guomingloo/planar-acoustic-gripper/experiment_data/BeadSize/WhatsApp Image 2026-06-30 at 16.32.45.jpeg

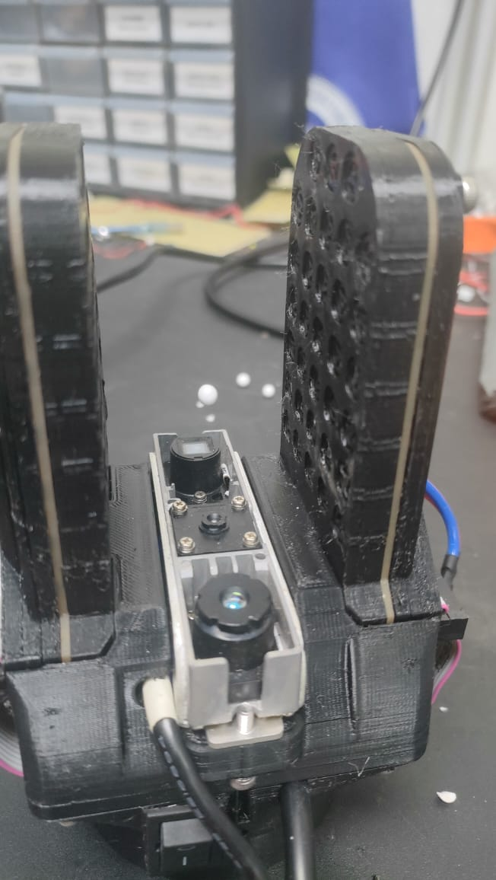
experiment_data/BeadSize/WhatsApp Image 2026-06-30 at 16.32.45.jpeg
