guomingloo/planar-acoustic-gripper/experiment_data/BeadSize/3.8mmEPS.jpeg

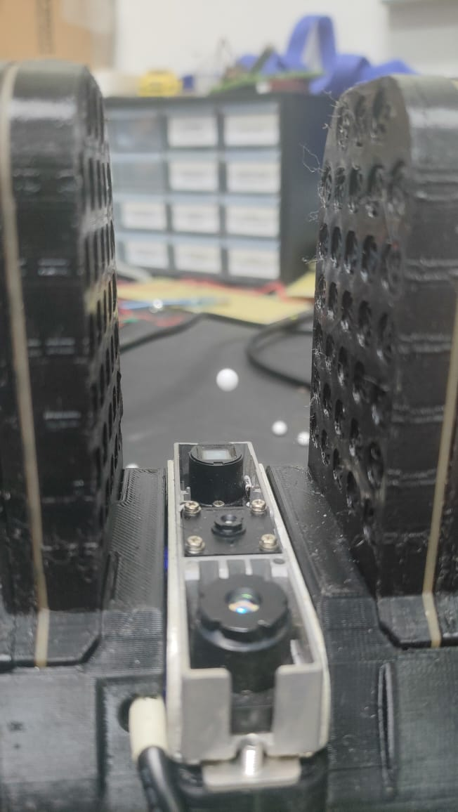
experiment_data/BeadSize/3.8mmEPS.jpeg
