guomingloo/planar-acoustic-gripper/README.md

# planar-acoustic-gripper
Source code ,simulation logs and design files for a 66-channel flat-panel ultrasonic phased array acoustic gripper based on Cyclone IV FPGA integrated with a FLEXIV Rizon 4s 7-DOF robot. EE FYP 2025/2026, Universiti Sains Malaysia (USM).
