guomingloo/planar-acoustic-gripper/Electrical/AcousticGripper/AcousticGripper.step

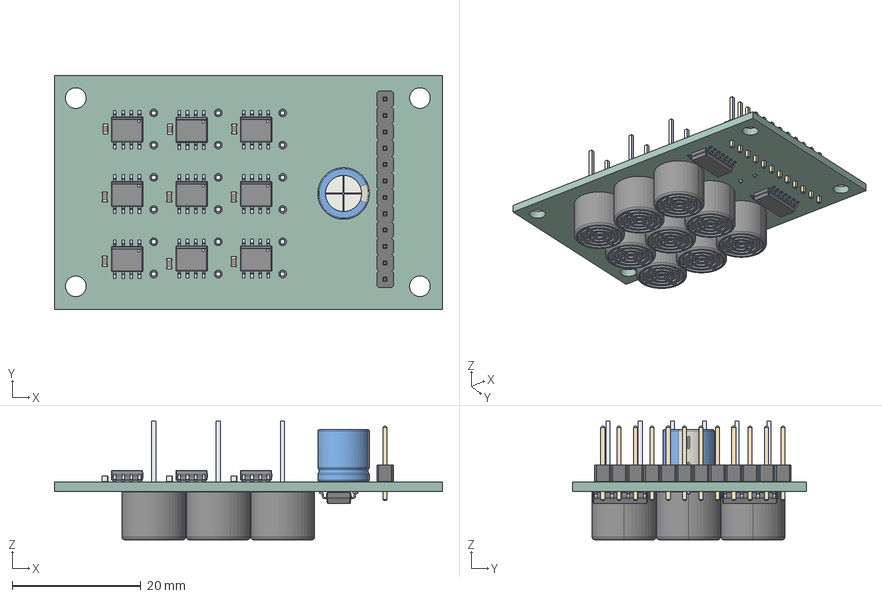
[picture p3: CAD file, 2026-07-02]
Electrical/AcousticGripper/AcousticGripper.step
60.2 x 36.3 x 18.4 mm
DRV8870DDAR x 9
C_0603_1608Metric x 9
CP_Radial_D8.0mm_P3.50mm
PinHeader_1x12_P2.54mm_Vertical
SOIC-14_3.9x8.7mm_P1.27mm x 2
MA40S4R--3DModel-STEP-56544 x 9
AcousticGripper_PCB
