guomingloo/planar-acoustic-gripper/Electrical/BaseStationV1/BaseStationPart2/BaseStationPart2.step

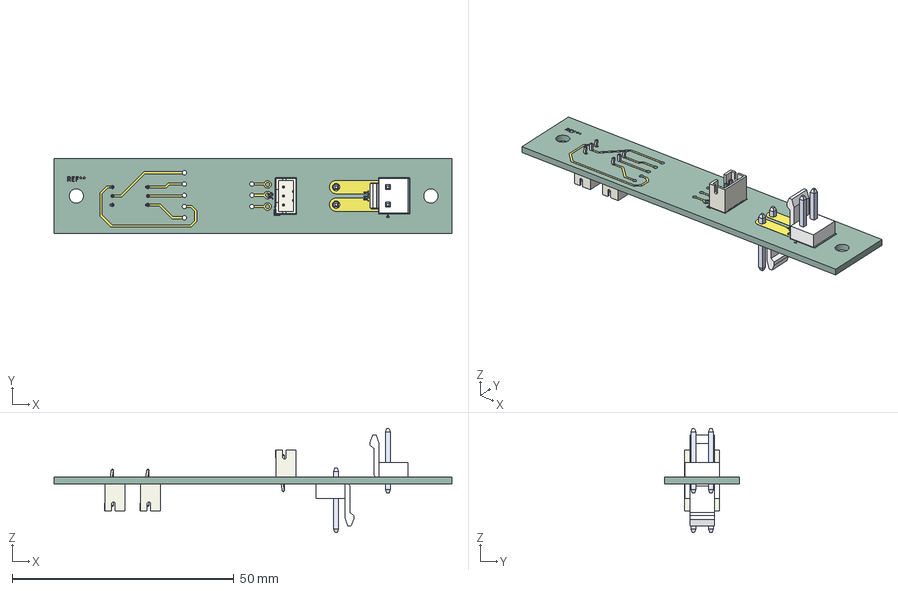
[picture p4: CAD file, 2026-07-02]
Electrical/BaseStationV1/BaseStationPart2/BaseStationPart2.step
89.8 x 17.0 x 23.5 mm
B2P-VH(LF)(SN)_B2P-VH(LF)(SN) x 2
JST_PH_B3B-PH-K_1x03_P2.00mm_Vertical x 3
BaseStationPart2_copper
BaseStationPart2_silkscreen
BaseStationPart2_PCB
