guomingloo/planar-acoustic-gripper/Mechanical/FinalGripperV1.1/MoBo_Case_Middle.SLDPRT

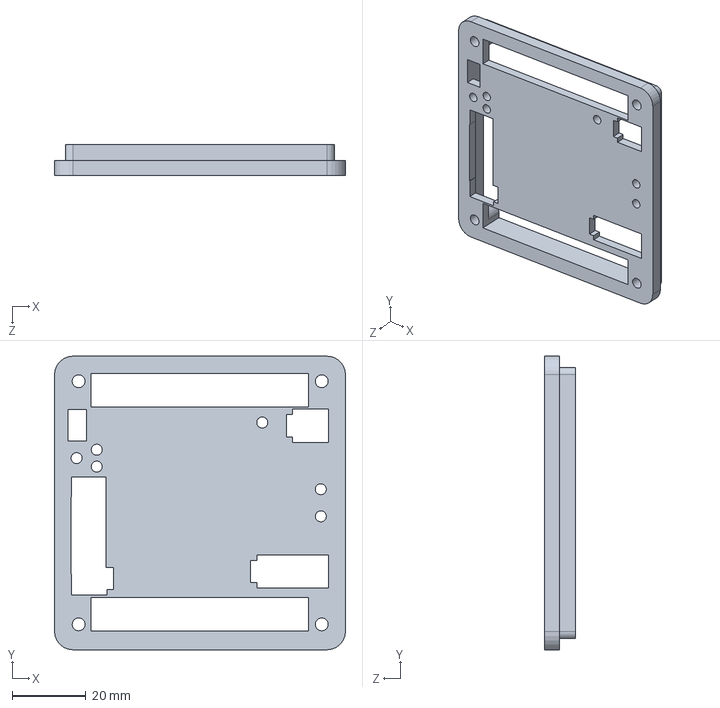
[picture p5: CAD file, 2026-07-02]
Mechanical/FinalGripperV1.1/MoBo_Case_Middle.SLDPRT
79.0 x 79.7 x 8.35 mm
