guomingloo/planar-acoustic-gripper/Mechanical/BaseSationV1/Top_Mid_Frame.SLDPRT

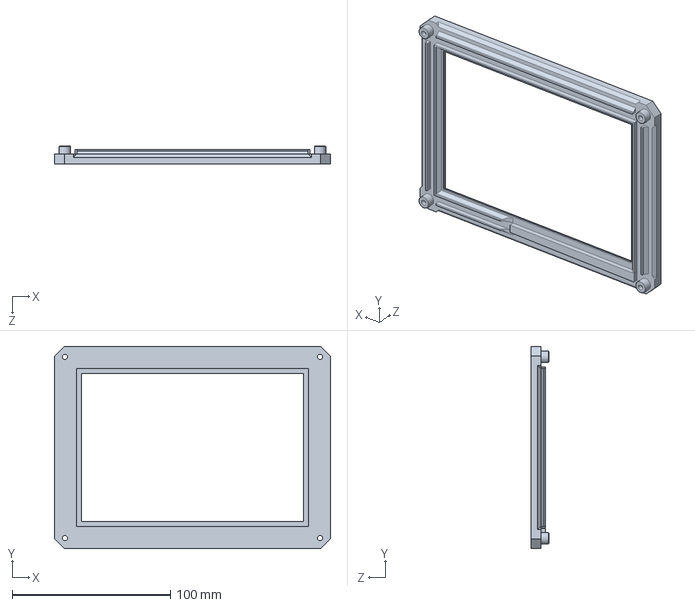
[picture p6: CAD file, 2026-07-02]
Mechanical/BaseSationV1/Top_Mid_Frame.SLDPRT
174.5 x 127.8 x 11.1 mm
