guomingloo/planar-acoustic-gripper/Mechanical/FinalGripperV1.1/Coupler.SLDPRT

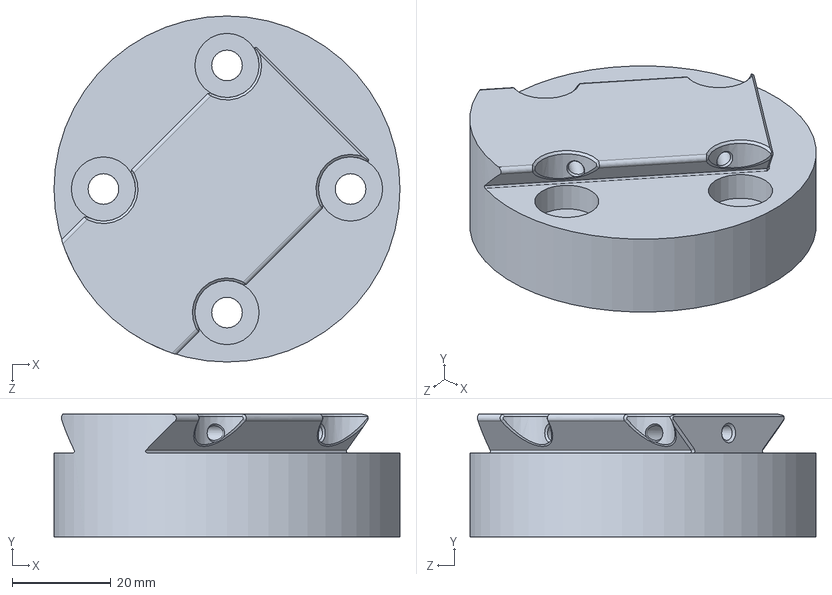
[picture p7: CAD file, 2026-07-02]
Mechanical/FinalGripperV1.1/Coupler.SLDPRT
70.0 x 24.8 x 70.0 mm
