guomingloo/planar-acoustic-gripper/Mechanical/PoC_Gripper/sGripperCase.SLDPRT

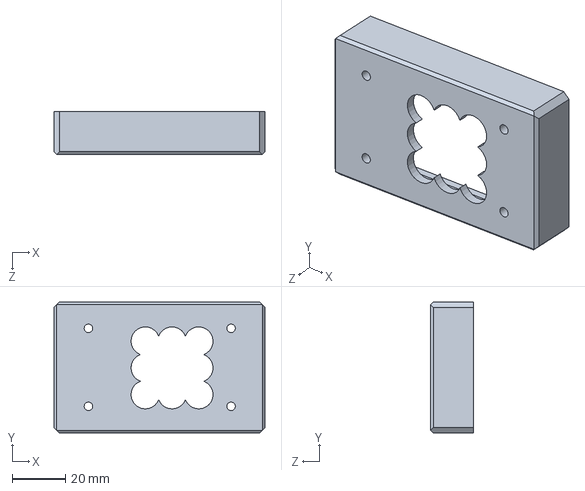
[picture p8: CAD file, 2026-07-02]
Mechanical/PoC_Gripper/sGripperCase.SLDPRT
79.0 x 49.0 x 16.0 mm
