guomingloo/planar-acoustic-gripper/Mechanical/BaseSationV1/Boost_Converter.step

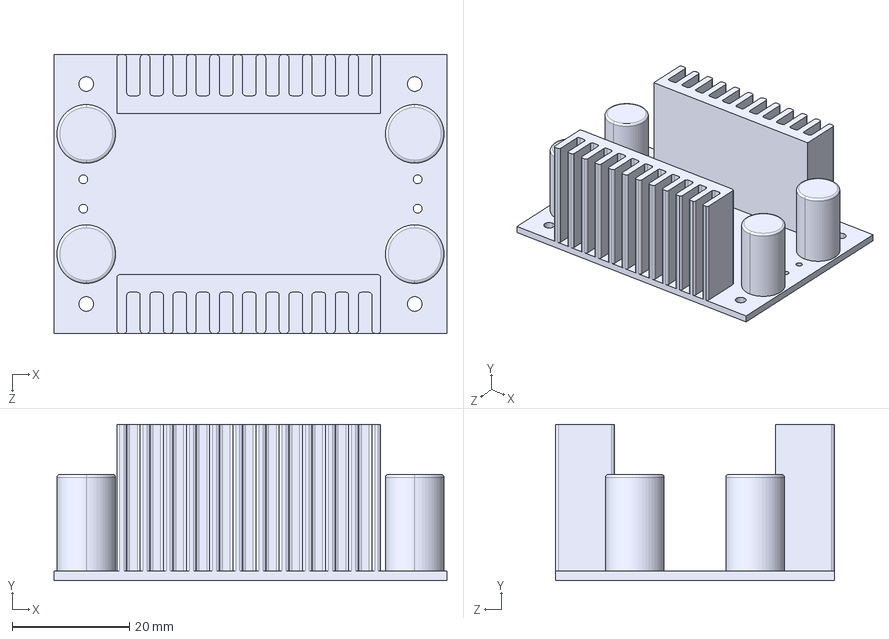
[picture p9: CAD file, 2026-07-02]
Mechanical/BaseSationV1/Boost_Converter.step
67.0 x 26.6 x 47.5 mm
