guomingloo/planar-acoustic-gripper/Mechanical/FinalGripperV1.1/final_Gripper_Case_Middle.SLDPRT

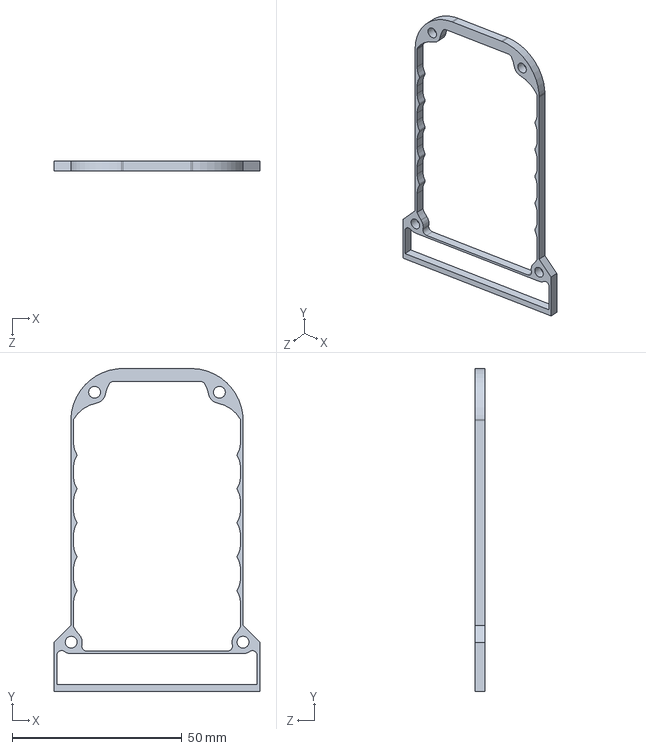
[picture p10: CAD file, 2026-07-02]
Mechanical/FinalGripperV1.1/final_Gripper_Case_Middle.SLDPRT
60.6 x 95.2 x 3.00 mm
