guomingloo/planar-acoustic-gripper/Mechanical/PoC_Gripper/cPlat.SLDPRT

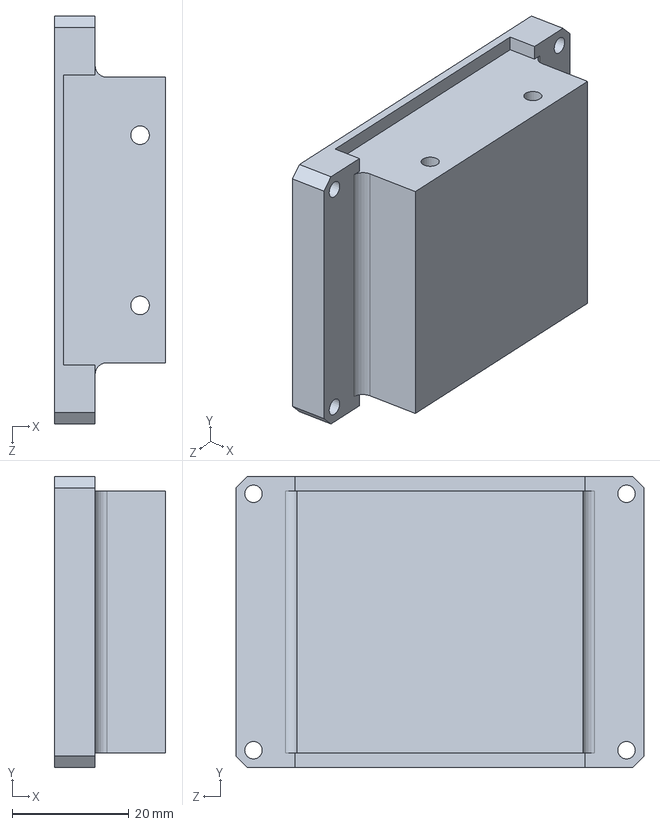
[picture p11: CAD file, 2026-07-02]
Mechanical/PoC_Gripper/cPlat.SLDPRT
19.1 x 50.0 x 70.0 mm
