guomingloo/planar-acoustic-gripper/Mechanical/BaseSationV1/Side_Frame.SLDPRT

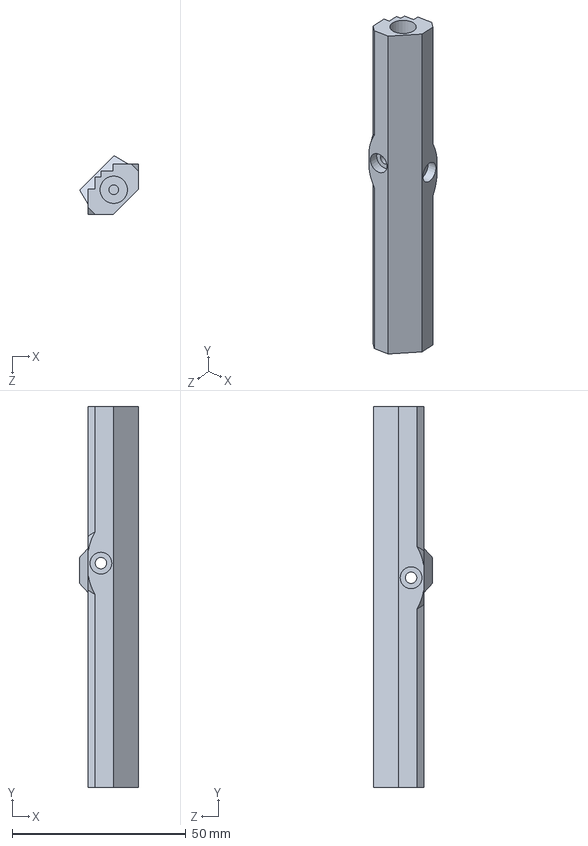
[picture p12: CAD file, 2026-07-02]
Mechanical/BaseSationV1/Side_Frame.SLDPRT
16.9 x 109.7 x 16.9 mm
