guomingloo/planar-acoustic-gripper/Mechanical/FinalGripperV1.1/final_Gripper_Case_Top_Blank.SLDPRT

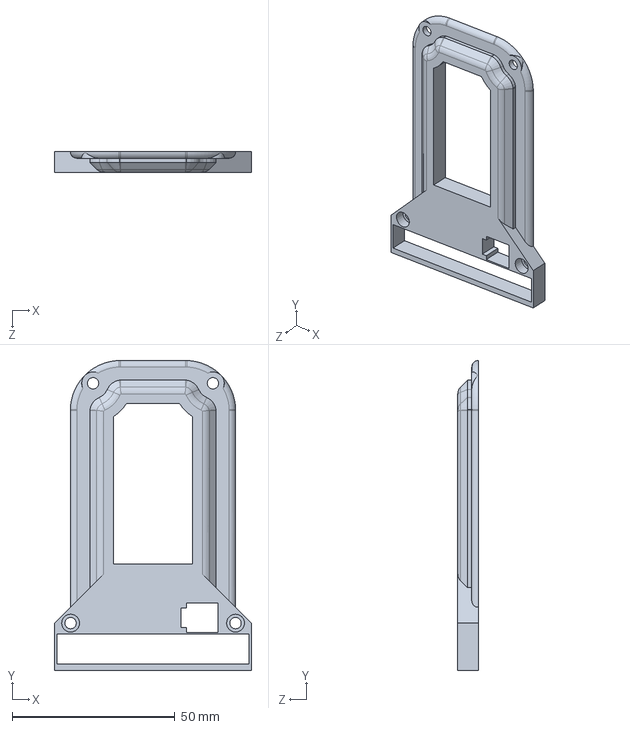
[picture p13: CAD file, 2026-07-02]
Mechanical/FinalGripperV1.1/final_Gripper_Case_Top_Blank.SLDPRT
60.6 x 95.2 x 6.30 mm
