guomingloo/planar-acoustic-gripper/Mechanical/BaseSationV1/Top_Frame.SLDPRT

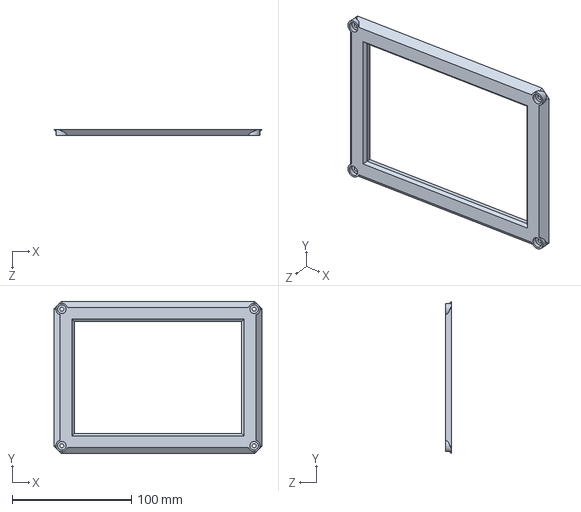
[picture p14: CAD file, 2026-07-02]
Mechanical/BaseSationV1/Top_Frame.SLDPRT
174.5 x 127.8 x 5.00 mm
