guomingloo/planar-acoustic-gripper/Mechanical/FinalGripperV1.1/MoBo_Case.SLDPRT

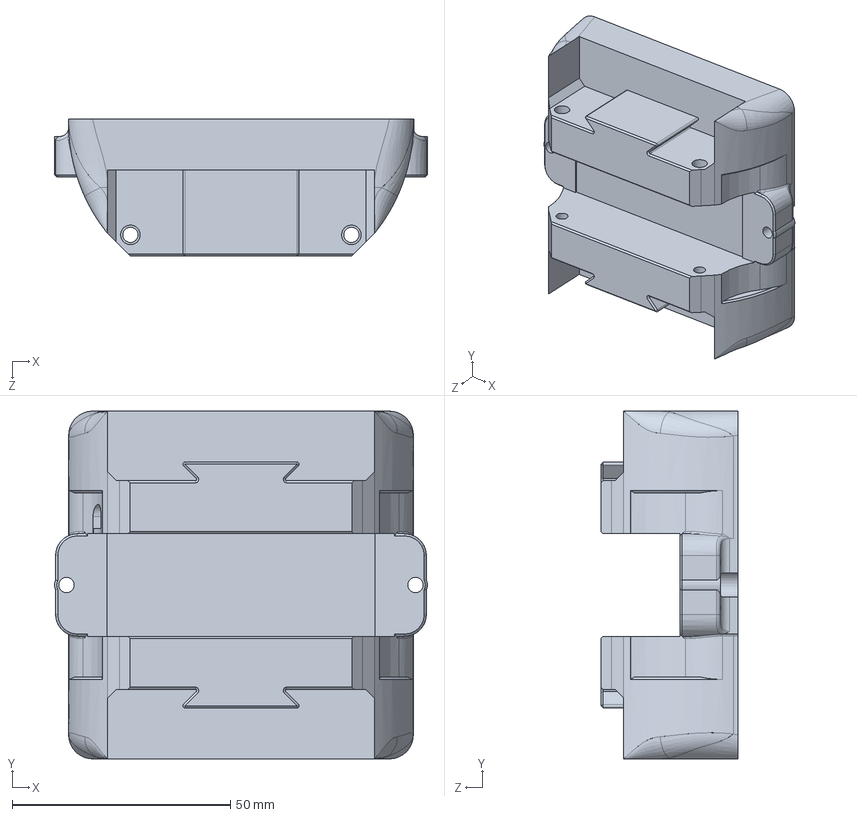
[picture p15: CAD file, 2026-07-02]
Mechanical/FinalGripperV1.1/MoBo_Case.SLDPRT
85.5 x 79.7 x 31.4 mm
