guomingloo/planar-acoustic-gripper/Mechanical/BaseSationV1/middle_frame.SLDPRT

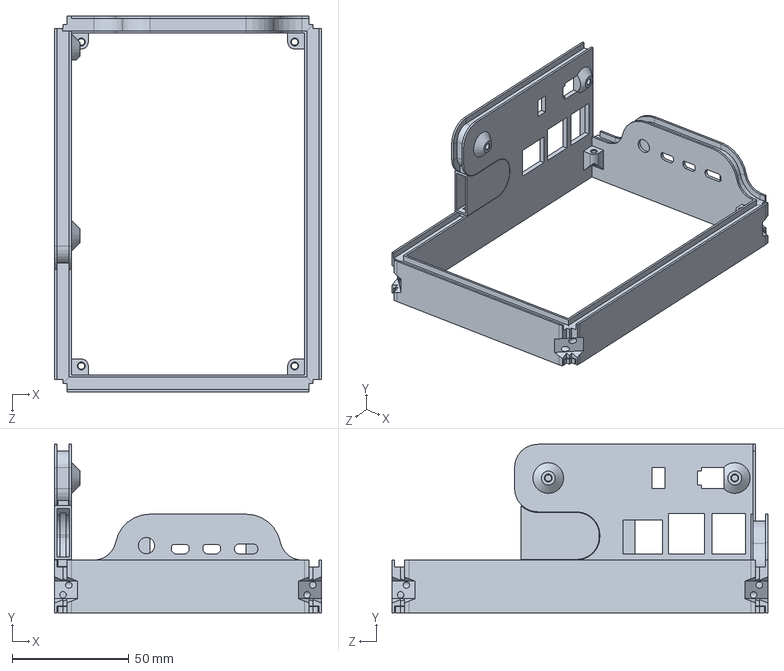
[picture p16: CAD file, 2026-07-02]
Mechanical/BaseSationV1/middle_frame.SLDPRT
114.6 x 72.3 x 161.3 mm
