guomingloo/planar-acoustic-gripper/Mechanical/FinalGripperV1.1/final_Gripper_Case_Bottom.SLDPRT

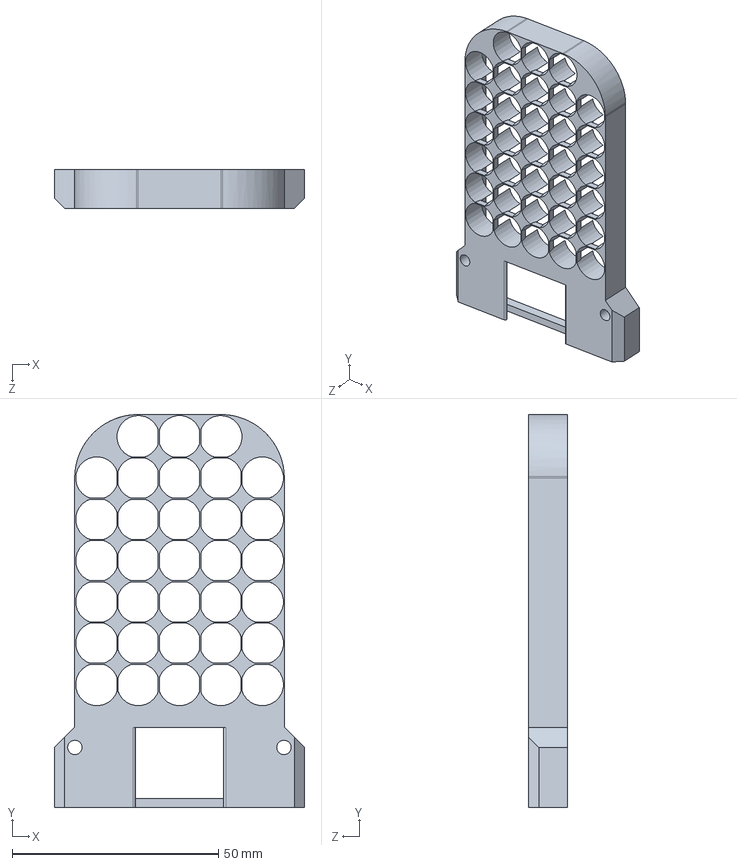
[picture p17: CAD file, 2026-07-02]
Mechanical/FinalGripperV1.1/final_Gripper_Case_Bottom.SLDPRT
60.6 x 95.2 x 9.44 mm
