guomingloo/planar-acoustic-gripper/Mechanical/FinalGripperV1.1/final_Gripper_Case_Top.SLDPRT

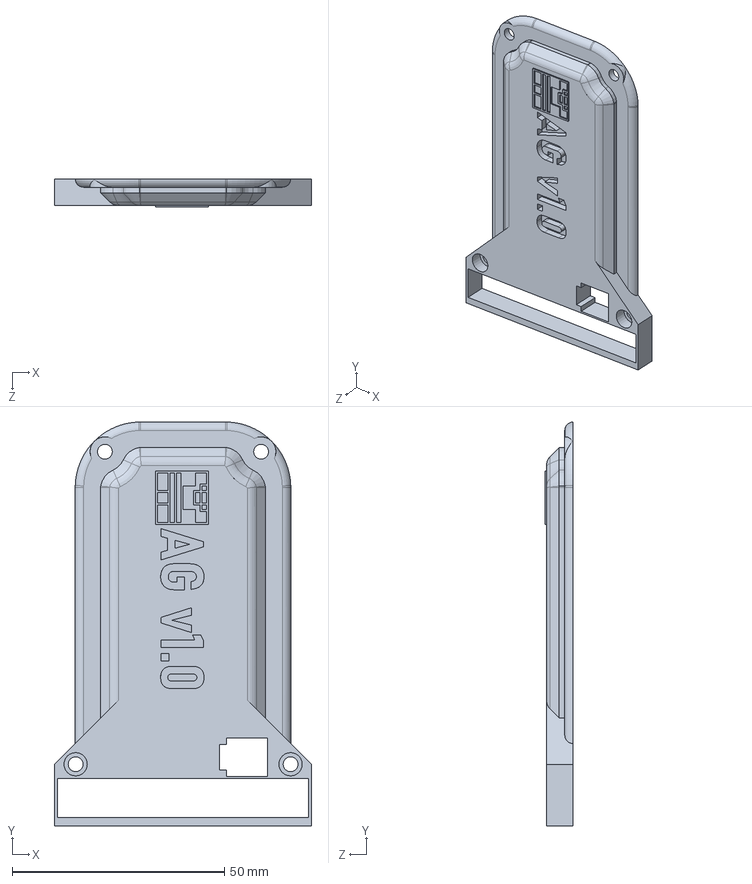
[picture p18: CAD file, 2026-07-02]
Mechanical/FinalGripperV1.1/final_Gripper_Case_Top.SLDPRT
60.6 x 95.2 x 6.70 mm
