guomingloo/planar-acoustic-gripper/Mechanical/FinalGripperV1.1/MoBo_Case_Top.SLDPRT

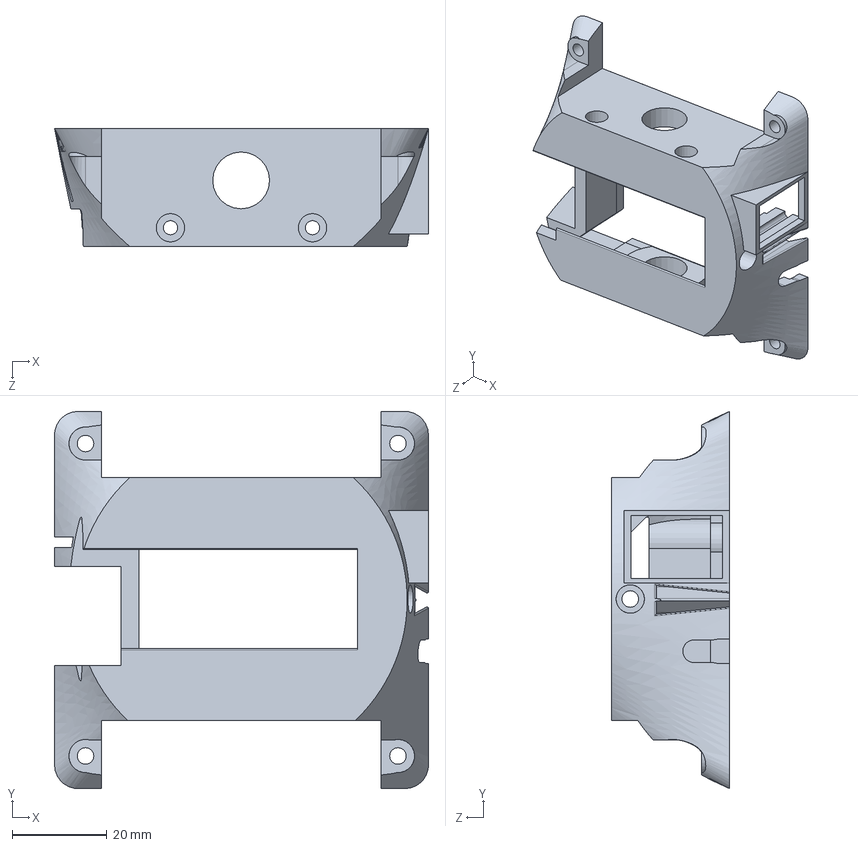
[picture p19: CAD file, 2026-07-02]
Mechanical/FinalGripperV1.1/MoBo_Case_Top.SLDPRT
79.0 x 79.7 x 25.0 mm
