guomingloo/planar-acoustic-gripper/Mechanical/PoC_Gripper/Assem3.SLDASM

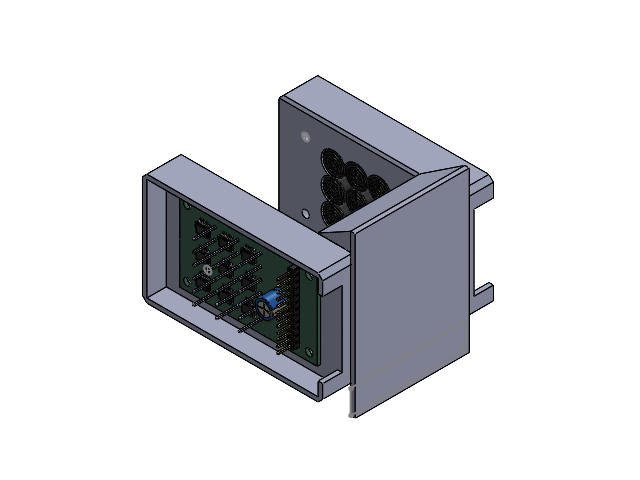
[picture p20: CAD file, 2026-07-02]
Mechanical/PoC_Gripper/Assem3.SLDASM
DRV8870DDAR_1.step x 9
C_0603_1608Metric_1.step x 9
CP_Radial_D8.0mm_P3.50mm_1.step
PinHeader_1x12_P2.54mm_Vertical_1.step
SOIC-14_3.9x8.7mm_P1.27mm_1.step x 2
MA40S4R--3DModel-STEP-56544_1.step x 9
AcousticGripper_PCB_1.step
DRV8870DDAR.step x 9
C_0603_1608Metric.step x 9
CP_Radial_D8.0mm_P3.50mm.step
PinHeader_1x12_P2.54mm_Vertical.step
SOIC-14_3.9x8.7mm_P1.27mm.step x 2
MA40S4R--3DModel-STEP-56544.step x 9
AcousticGripper_PCB.step
sGripperCase x 2
cPlat
