guomingloo/planar-acoustic-gripper/experiment_data/Stability/Stability1.xlsx

t | x | y | 0.0001247677527 | 0.0002685738407
0 | -7.519e-05 | 0.0003387 | 0.0001229200384 | 8.627574153e-05
0.017 | -7.519e-05 | 0.0003387 | 0.00045979 | 0.0003199
0.034 | -7.519e-05 | 0.0003387
0.05 | -7.519e-05 | 0.0003387
0.067 | -7.519e-05 | 0.0003387
0.084 | -7.519e-05 | 0.0003387
0.101 | -7.519e-05 | 0.0003387
0.118 | -7.519e-05 | 0.0003387
0.135 | -7.519e-05 | 0.0003387
0.151 | -7.519e-05 | 0.0003387
0.168 | -7.519e-05 | 0.0003387
0.185 | -1.522e-05 | 0.0002587
0.202 | 6.475e-05 | 0.0002587
0.219 | 0.0001047 | 0.0002187
0.236 | 0.0001047 | 0.0002187
0.252 | 0.0001047 | 0.0002187
0.269 | 0.0001047 | 0.0002187
0.286 | 0.0001047 | 0.0002187
0.303 | 0.0001047 | 0.0002187
0.32 | 0.0001047 | 0.0002187
0.337 | 0.0001047 | 0.0002187
0.353 | 0.0001047 | 0.0002187
0.37 | 0.0001047 | 0.0002187
0.387 | 0.0001047 | 0.0002187
0.404 | 0.0001047 | 0.0002187
0.421 | 0.0001047 | 0.0002187
0.438 | 0.0001047 | 0.0002187
0.454 | 0.0001047 | 0.0002187
0.471 | 0.0001047 | 0.0002187
0.488 | 0.0001047 | 0.0002187
0.505 | 0.0001047 | 0.0002187
0.522 | 0.0001047 | 0.0002187
0.539 | 0.0001047 | 0.0002187
0.555 | 0.0001047 | 0.0002187
0.572 | 0.0001047 | 0.0002187
0.589 | 0.0001047 | 0.0002187
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
