guomingloo/planar-acoustic-gripper/experiment_data/x_movement_data/X_Movement.xlsx

t | x | y | X-axis(mm) | Z-axis(mm)
0 | 1.67e-05 | 1.518e-06 | 0.0167 | 0.001518 | 3.522 | -4.001
0.306 | -0.0001786 | 4.925e-05 | -0.1786 | 0.04925
0.612 | -0.0003495 | 7.04e-05 | -0.3495 | 0.0704
0.917 | -0.0003252 | 3.995e-05 | -0.3252 | 0.03995
1.223 | -0.0003544 | -3.478e-05 | -0.3544 | -0.03478
1.529 | -0.0003634 | -3.874e-05 | -0.3634 | -0.03874
1.835 | -0.0005385 | 5.433e-05 | -0.5385 | 0.05433
2.141 | -0.0006227 | -7.347e-06 | -0.6227 | -0.007347
2.446 | -0.0006244 | 4.433e-05 | -0.6244 | 0.04433
2.752 | -0.0007057 | 8.334e-05 | -0.7057 | 0.08334
3.058 | -0.0006263 | 5.906e-05 | -0.6263 | 0.05906
3.364 | -0.0008628 | 9.923e-05 | -0.8628 | 0.09923
3.67 | -0.0009029 | 0.0001246 | -0.9029 | 0.1246
3.976 | -0.0007547 | -6.003e-07 | -0.7547 | -0.0006003
4.281 | -0.0008637 | -1.738e-05 | -0.8637 | -0.01738
4.587 | -0.0009286 | -2.497e-05 | -0.9286 | -0.02497
4.893 | -0.001252 | 5.197e-05 | -1.252 | 0.05197
5.199 | -0.001261 | 5.545e-05 | -1.261 | 0.05545
5.505 | -0.0012 | -3.404e-05 | -1.2 | -0.03404
5.81 | -0.001129 | -7.849e-06 | -1.129 | -0.007849
6.116 | -0.001236 | 1.847e-05 | -1.236 | 0.01847
6.422 | -0.001451 | 9.281e-05 | -1.451 | 0.09281
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
