guomingloo/planar-acoustic-gripper/experiment_data/y_movement_data/Y_Movement.xlsx

t | Y-axis | Z-axis | Y-axis(mm) | Z-axis(mm)
0 | 6.495e-06 | -6.554e-06 | 0.006495 | -0.006554
0.017 | 1.588e-05 | -1.124e-05 | 0.01588 | -0.01124
0.034 | 4.861e-05 | -6.978e-06 | 0.04861 | -0.006978
0.051 | 4.364e-05 | 3.283e-05 | 0.04364 | 0.03283
0.067 | 4.364e-05 | 3.283e-05 | 0.04364 | 0.03283
0.084 | 4.364e-05 | 3.283e-05 | 0.04364 | 0.03283
0.101 | 4.364e-05 | 3.283e-05 | 0.04364 | 0.03283
0.118 | 4.364e-05 | 3.283e-05 | 0.04364 | 0.03283
0.135 | 4.364e-05 | 3.283e-05 | 0.04364 | 0.03283
0.152 | 4.364e-05 | 3.283e-05 | 0.04364 | 0.03283
0.169 | 3.368e-05 | 3.283e-05 | 0.03368 | 0.03283
0.185 | 2.373e-05 | 3.283e-05 | 0.02373 | 0.03283
0.202 | 5.359e-05 | 3.283e-05 | 0.05359 | 0.03283
0.219 | 8.344e-05 | 3.283e-05 | 0.08344 | 0.03283
0.236 | 0.0001083 | 4.278e-05 | 0.1083 | 0.04278
0.253 | 0.0001083 | 4.278e-05 | 0.1083 | 0.04278
0.27 | 0.0001133 | 6.269e-05 | 0.1133 | 0.06269
0.286 | 0.0001133 | 9.752e-05 | 0.1133 | 0.09752
0.303 | 0.0001133 | 8.757e-05 | 0.1133 | 0.08757
0.32 | 0.0001133 | 8.757e-05 | 0.1133 | 0.08757
0.337 | 0.0001183 | 8.259e-05 | 0.1183 | 0.08259
0.354 | 0.0001183 | 8.259e-05 | 0.1183 | 0.08259
0.371 | 0.0001183 | 8.259e-05 | 0.1183 | 0.08259
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
