guomingloo/planar-acoustic-gripper/experiment_data/BeadSize/2.3mmEPS.jpeg

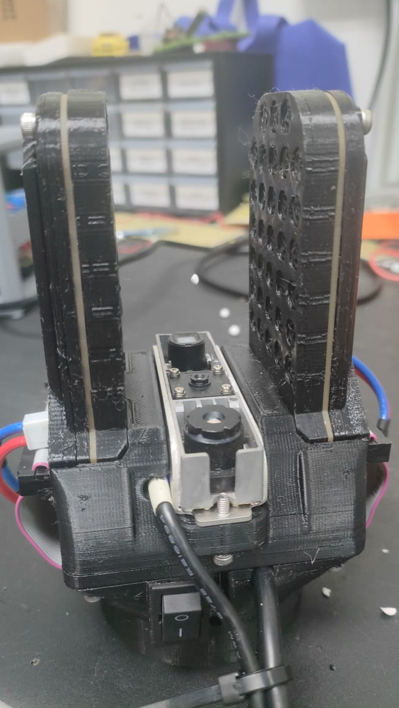
experiment_data/BeadSize/2.3mmEPS.jpeg
