guomingloo/planar-acoustic-gripper/experiment_data/BeadSize/2.5mmEPS.jpeg

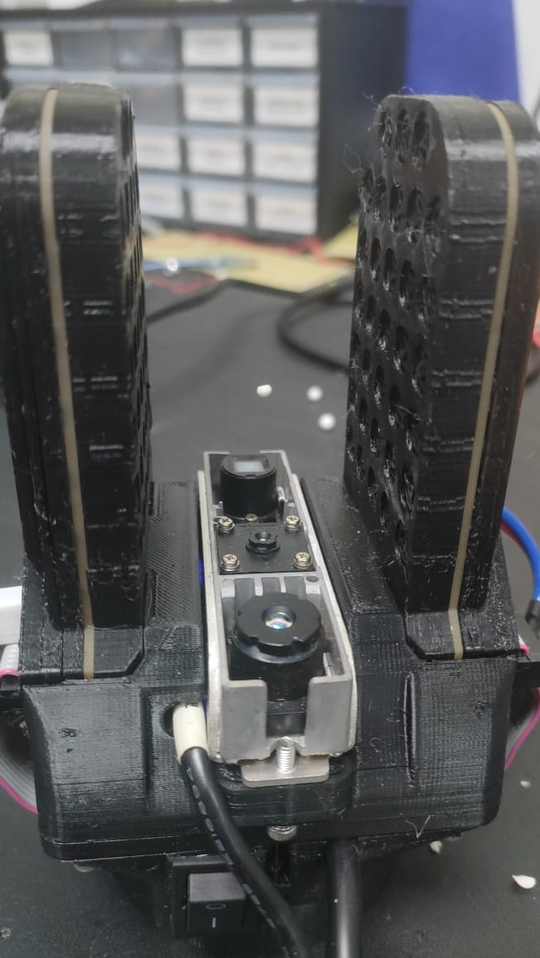
experiment_data/BeadSize/2.5mmEPS.jpeg
