guomingloo/planar-acoustic-gripper/experiment_data/BeadSize/2.8mmEPS.jpeg

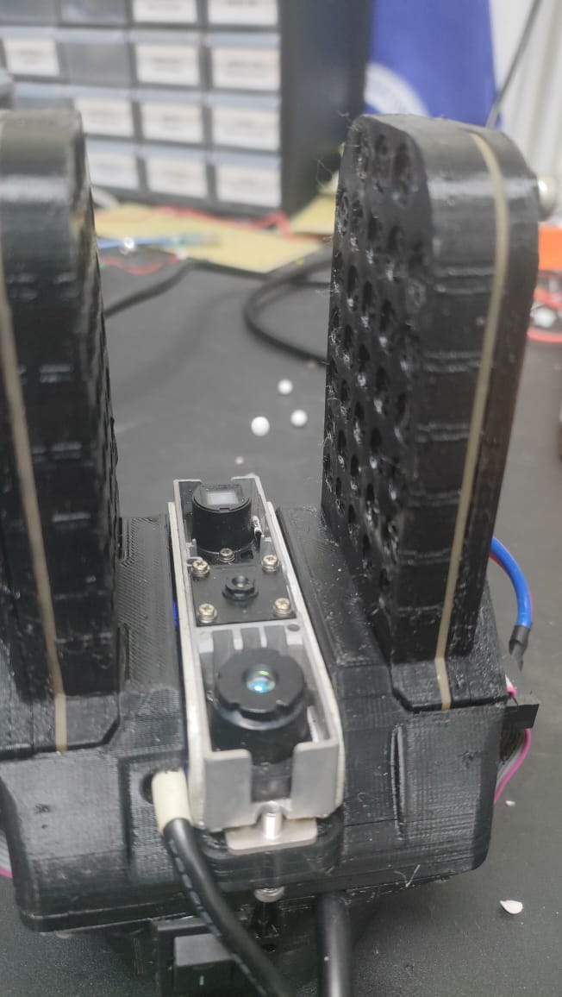
experiment_data/BeadSize/2.8mmEPS.jpeg
