guomingloo/planar-acoustic-gripper/experiment_data/BeadSize/3.4mmEPS.jpeg

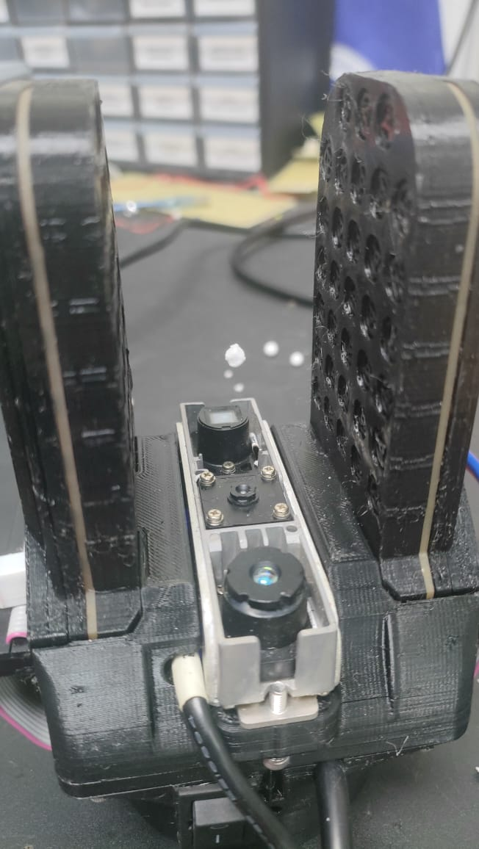
experiment_data/BeadSize/3.4mmEPS.jpeg
