guomingloo/planar-acoustic-gripper/experiment_data/BeadSize/3mmEPS.jpeg

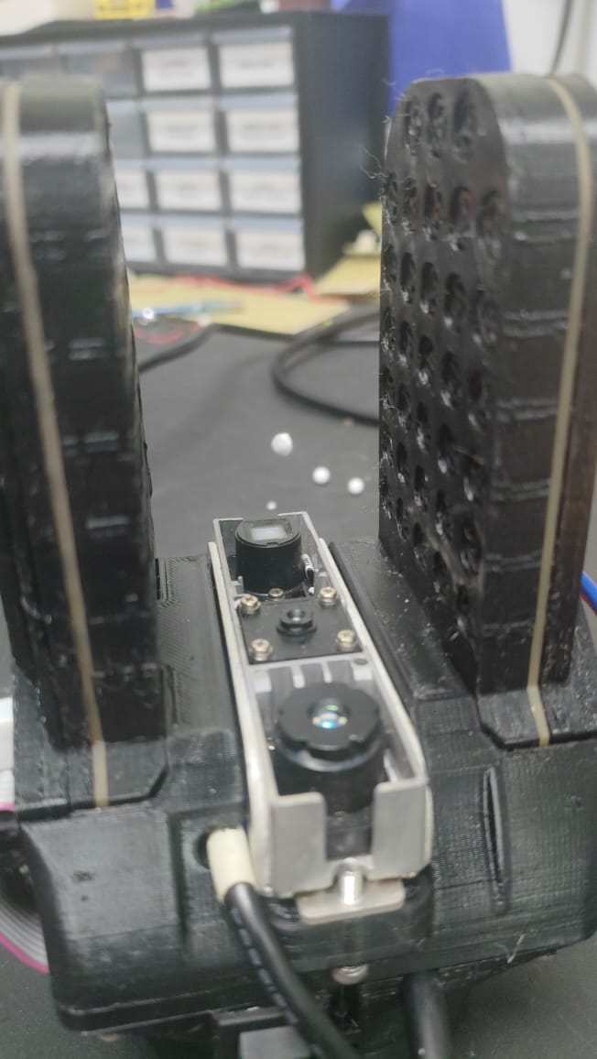
experiment_data/BeadSize/3mmEPS.jpeg
