guomingloo/planar-acoustic-gripper/experiment_data/BeadSize/WhatsApp Image 2026-06-30 at 16.32.46(1).jpeg

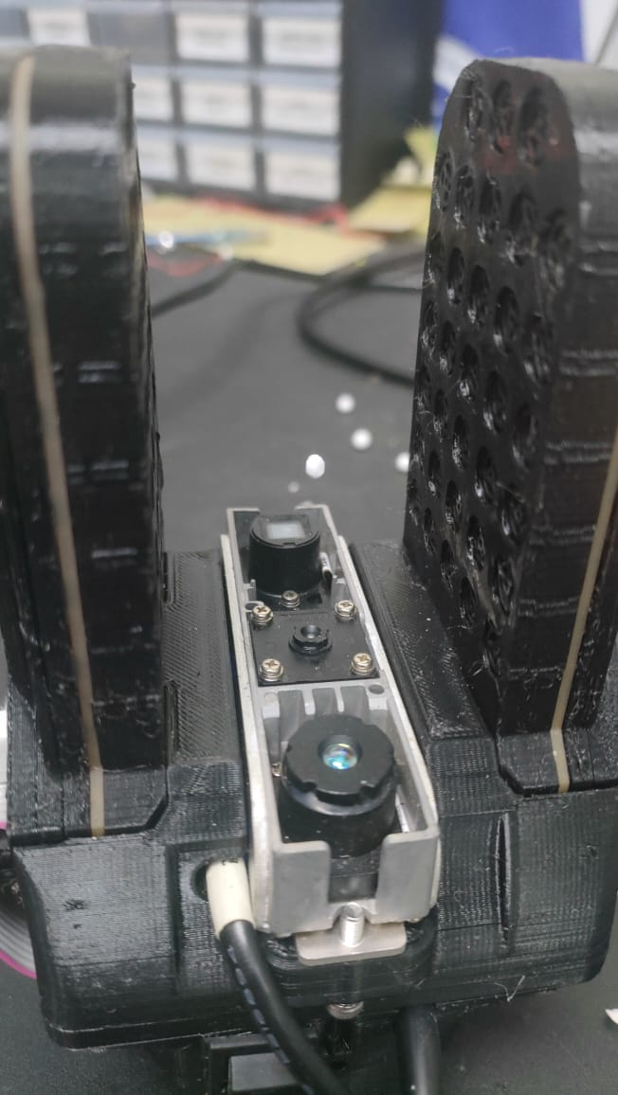
experiment_data/BeadSize/WhatsApp Image 2026-06-30 at 16.32.46(1).jpeg
