guomingloo/planar-acoustic-gripper/experiment_data/Repeatability/aligned_cycles.png

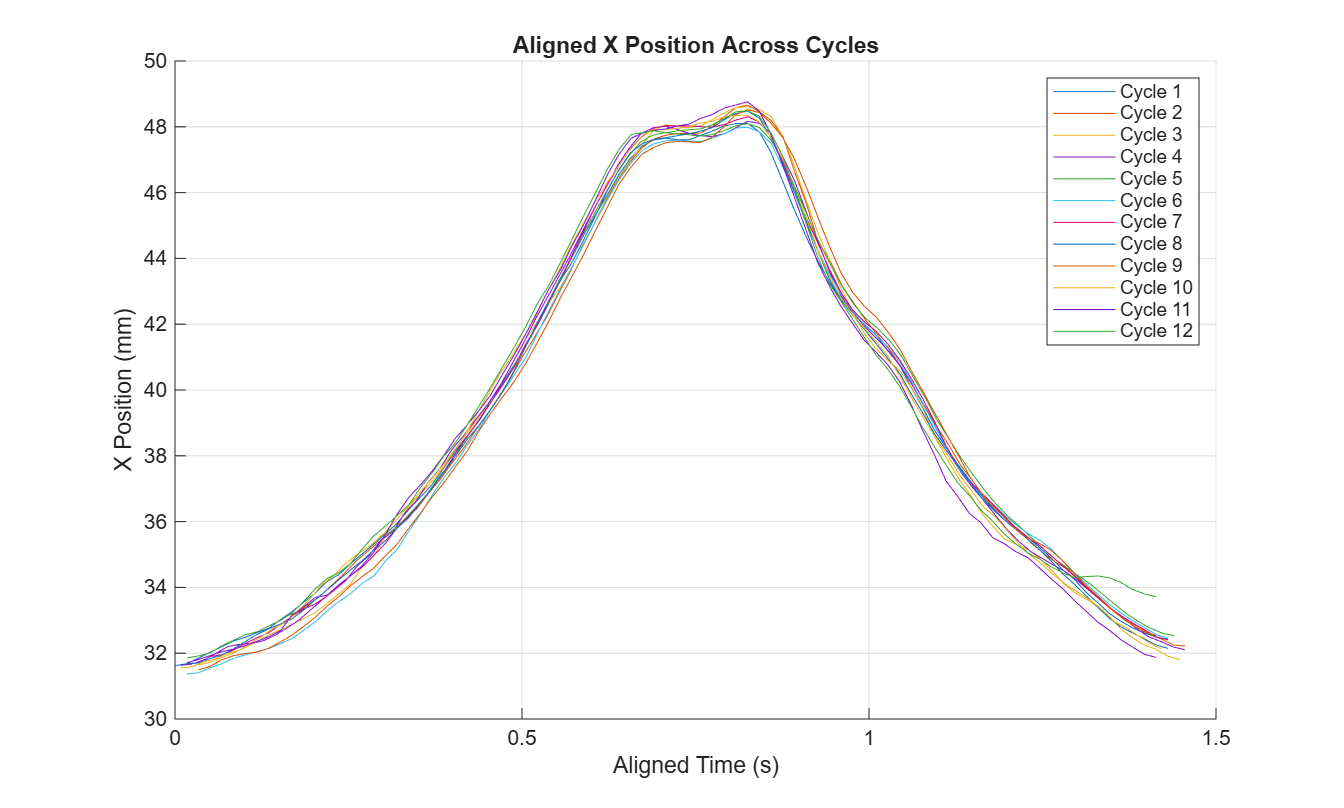
experiment_data/Repeatability/aligned_cycles.png
