guomingloo/planar-acoustic-gripper/experiment_data/Repeatability/IMG20260626162344.jpg

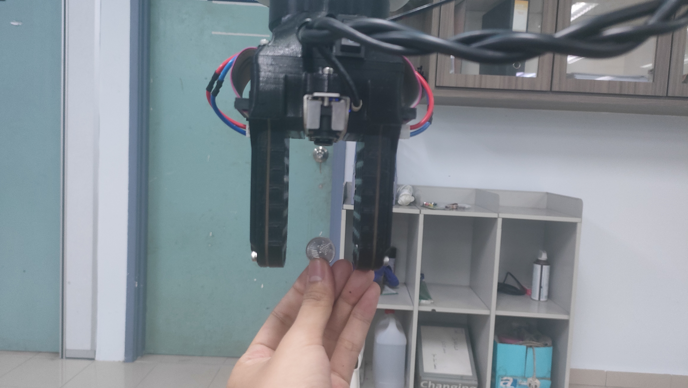
experiment_data/Repeatability/IMG20260626162344.jpg
