guomingloo/planar-acoustic-gripper/experiment_data/Repeatability/IMG20260626163721.jpg

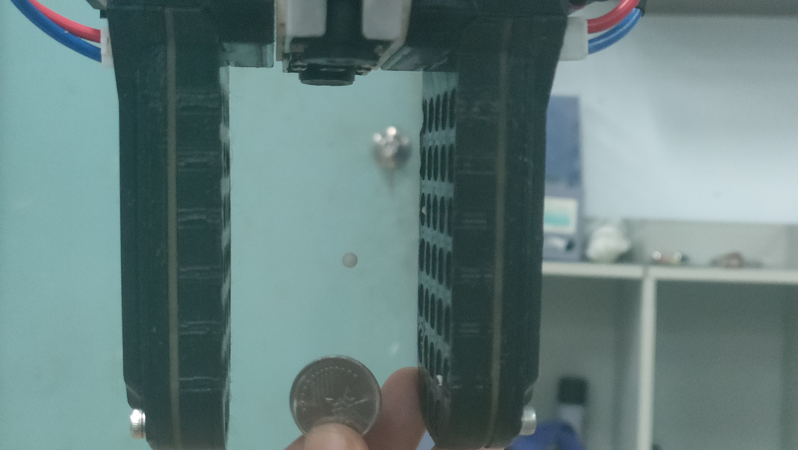
experiment_data/Repeatability/IMG20260626163721.jpg
