guomingloo/planar-acoustic-gripper/experiment_data/Repeatability/SD_X_position.png

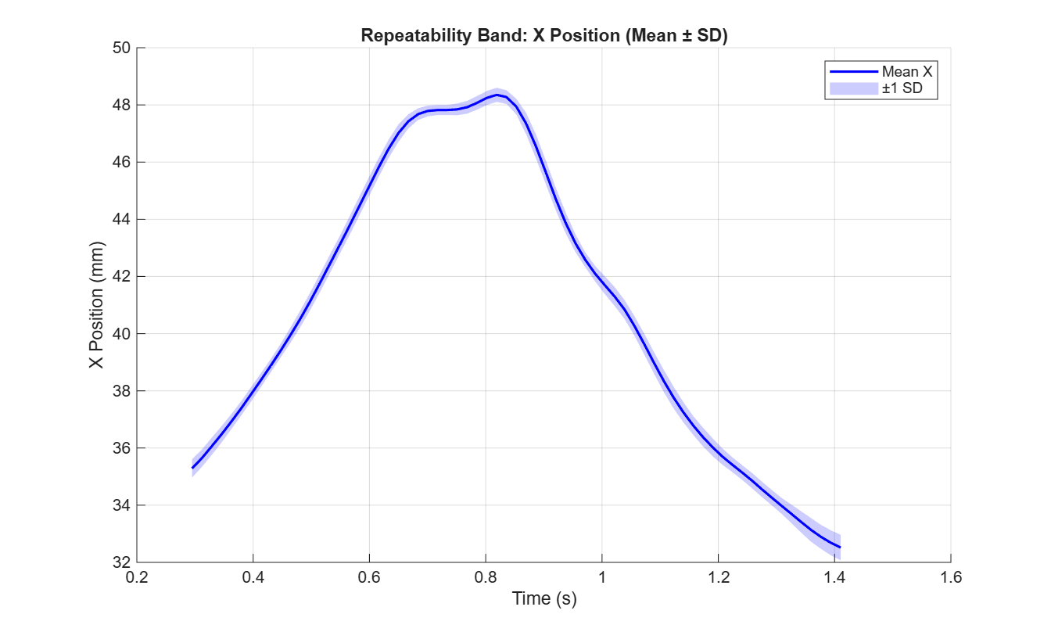
experiment_data/Repeatability/SD_X_position.png
