guomingloo/planar-acoustic-gripper/experiment_data/Repeatability/SD_Y_position.png

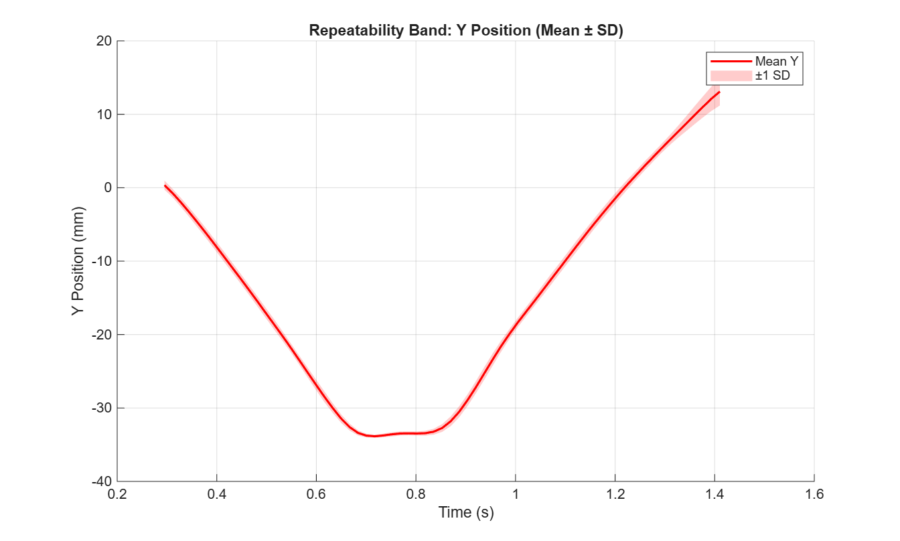
experiment_data/Repeatability/SD_Y_position.png
