guomingloo/planar-acoustic-gripper/experiment_data/Repeatability/traj.png

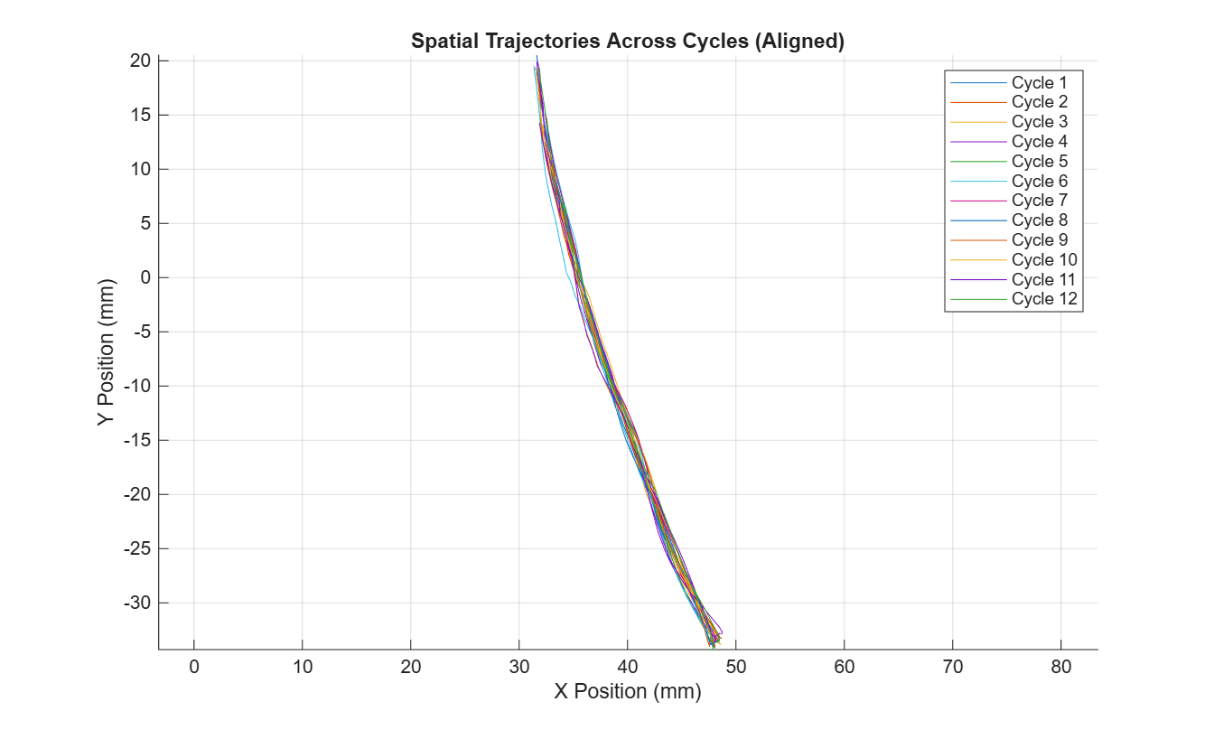
experiment_data/Repeatability/traj.png
