guomingloo/planar-acoustic-gripper/Electrical/BaseStationV1/BaseStationV1.kicad_pcb

## KiCad design Electrical/BaseStationV1/BaseStationV1.kicad_pcb (2026-07-02)

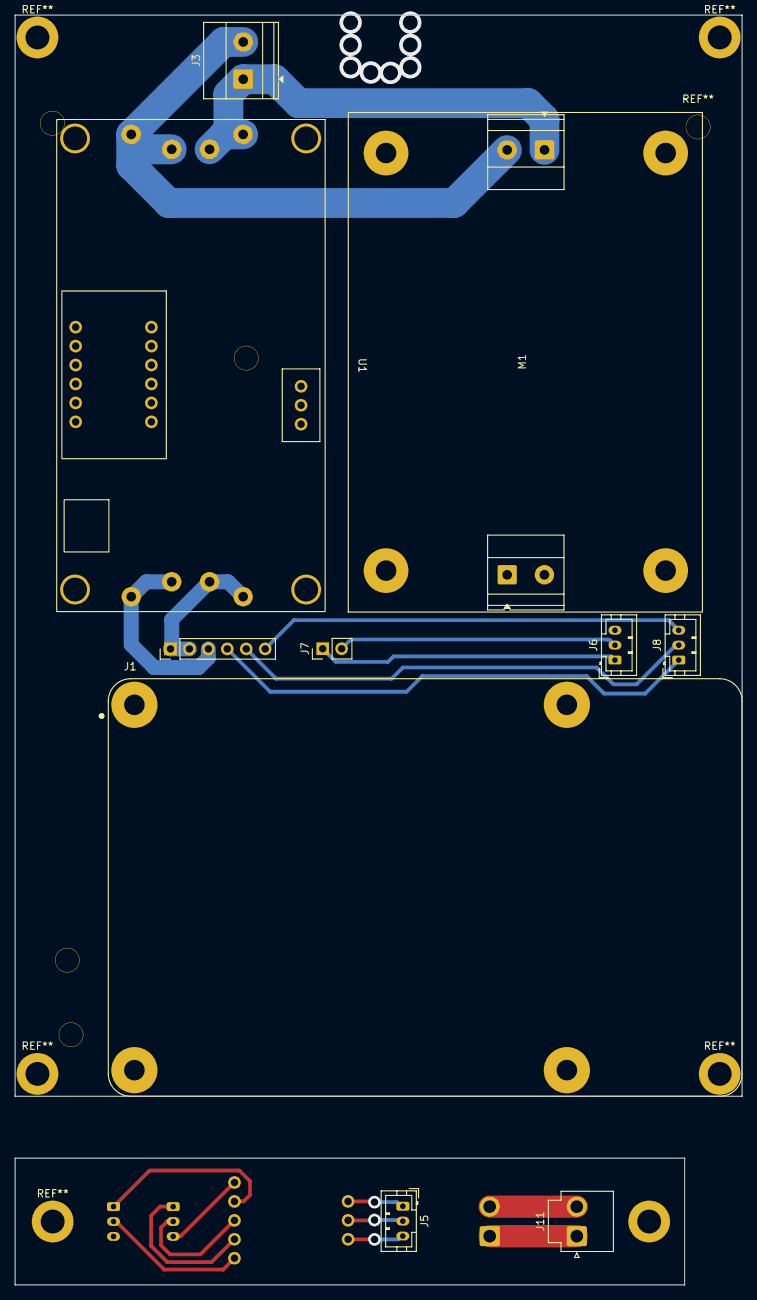
[picture p33: board BaseStationV1.kicad_pcb from above]

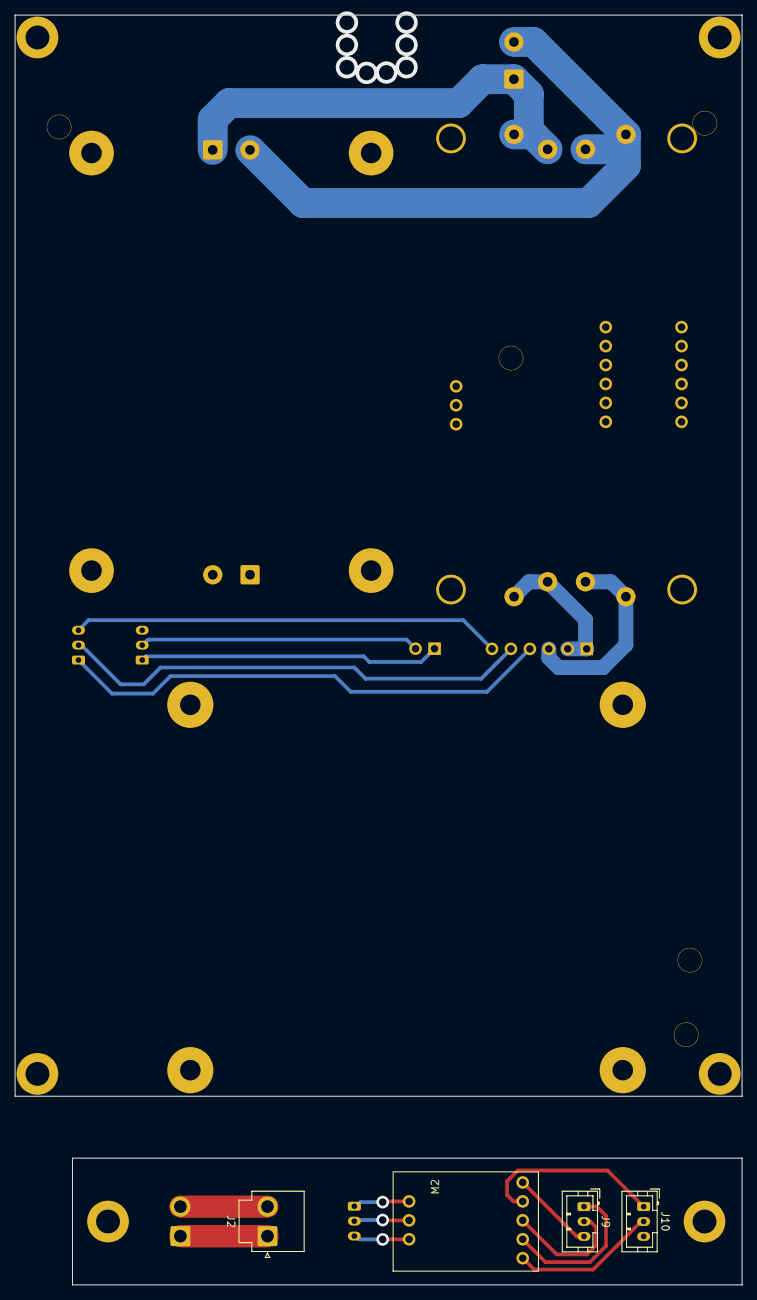
[picture p34: board BaseStationV1.kicad_pcb from below]

Board: 2 copper layers, 97.5 x 170.3 mm, 14 parts (4 on the bottom side), 13 nets.

Parts:
J1: Raspberry_Pi_4; MODULE_RASPBERRY_PI_4B_4GB
J2, J11: Conn_01x02_Pin; JST_VH_B2P-VH-B_1x02_P3.96mm_Vertical
J3: Screw_Terminal_01x02; TerminalBlock_Phoenix_MKDS-1,5-2_1x02_P5.00mm_Horizontal
J4: Conn_01x06_Pin; PinHeader_1x06_P2.54mm_Vertical
J5, J6, J8, J9, J10: Conn_01x03_Pin; JST_PH_B3B-PH-K_1x03_P2.00mm_Vertical
J7: Conn_01x02_Pin; PinHeader_1x02_P2.54mm_Vertical
M1: Boost_Converter_Module
M2: MAX3485_Module
U1: Module_LM2596_Display

Connections:
+3V3: J6.1, J7.1, J10.1, M2.7 (VCC)
+5V: J4.1, J4.2, U1.3 (OUT+)
GND: J4.3, J6.2, J7.2, J10.2, M2.4 (GND), U1.4 (OUT-)
unnamed: J4.4, J8.1, J9.1, M2.5 (TX)
unnamed: J4.5, J8.2, J9.2, M2.6 (RX)
unnamed: J4.6, J8.3, J9.3, M2.8 (EN)
unnamed: J3.1, M1.2 (IN+), U1.1 (IN+)
unnamed: J3.2, M1.1 (IN-), U1.2 (IN-)
unnamed: J5.1, M2.1 (B)
unnamed: J5.2, M2.2 (A)
unnamed: J5.3, M2.3 (GND)
unnamed: J2.1, J11.1
unnamed: J2.2, J11.2, M1.3 (OUT-)
