guomingloo/planar-acoustic-gripper/Electrical/BaseStationV1/BaseStationPart1/BaseStationPart1.kicad_pcb

## KiCad design Electrical/BaseStationV1/BaseStationPart1/BaseStationPart1.kicad_pcb (2026-07-02)

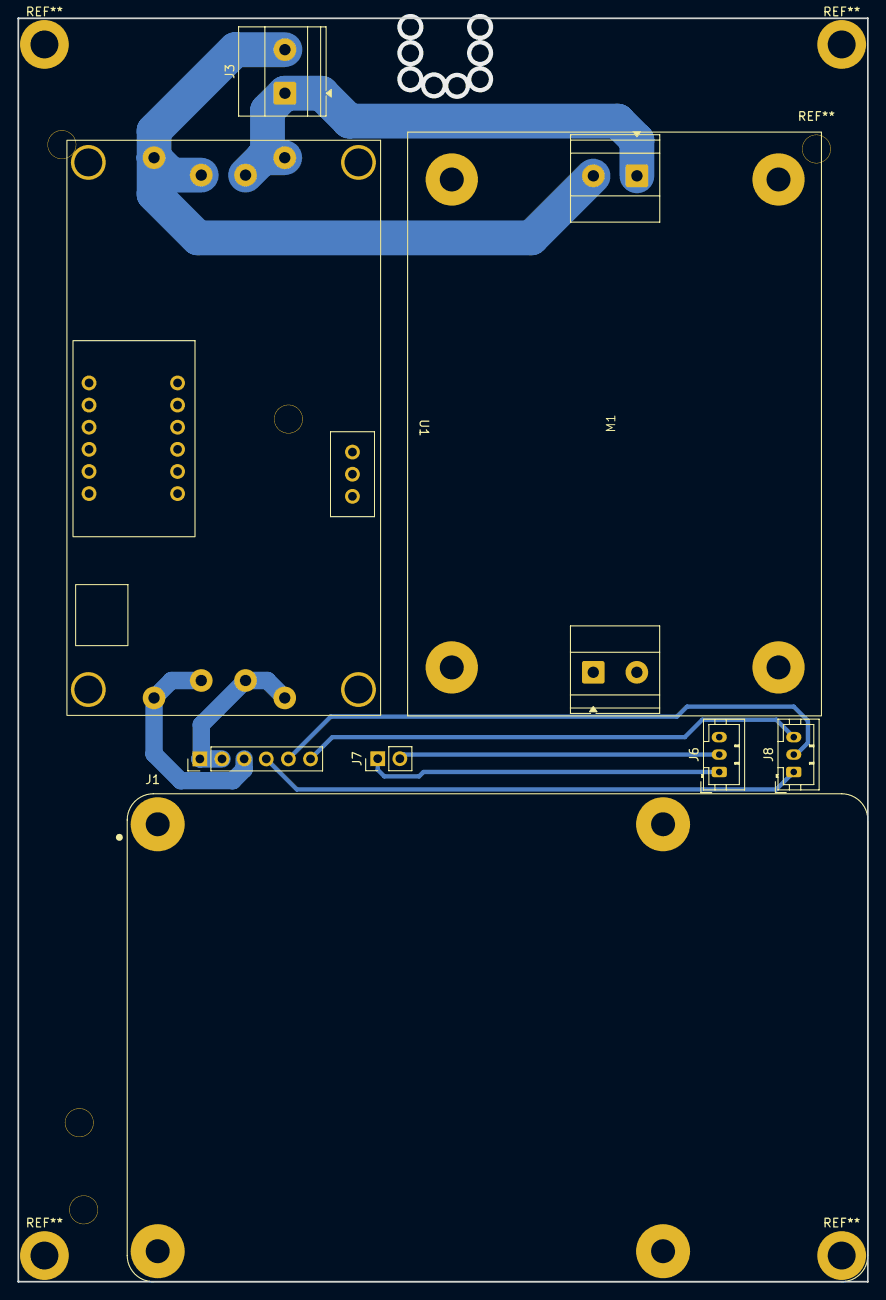
[picture p35: board BaseStationPart1.kicad_pcb from above]

Board: 2 copper layers, 97.5 x 145.0 mm, 8 parts (0 on the bottom side), 8 nets.

Parts:
J1: Raspberry_Pi_4; MODULE_RASPBERRY_PI_4B_4GB
J3: Screw_Terminal_01x02; TerminalBlock_Phoenix_MKDS-1,5-2_1x02_P5.00mm_Horizontal
J4: Conn_01x06_Pin; PinHeader_1x06_P2.54mm_Vertical
J6, J8: Conn_01x03_Pin; JST_PH_B3B-PH-K_1x03_P2.00mm_Vertical
J7: Conn_01x02_Pin; PinHeader_1x02_P2.54mm_Vertical
M1: Boost_Converter_Module
U1: Module_LM2596_Display

Connections:
+3V3: J6.1, J7.1
+5V: J4.1, J4.2, U1.3 (OUT+)
GND: J4.3, J6.2, J7.2, U1.4 (OUT-)
unnamed: J4.4, J8.1
unnamed: J4.5, J8.2
unnamed: J4.6, J8.3
unnamed: J3.1, M1.2 (IN+), U1.1 (IN+)
unnamed: J3.2, M1.1 (IN-), U1.2 (IN-)
