guomingloo/planar-acoustic-gripper/Electrical/AcousticGripper_MotherboardV1/AcousticGripper_MotherboardV1.kicad_pcb

## KiCad design Electrical/AcousticGripper_MotherboardV1/AcousticGripper_MotherboardV1.kicad_pcb (2026-07-02)

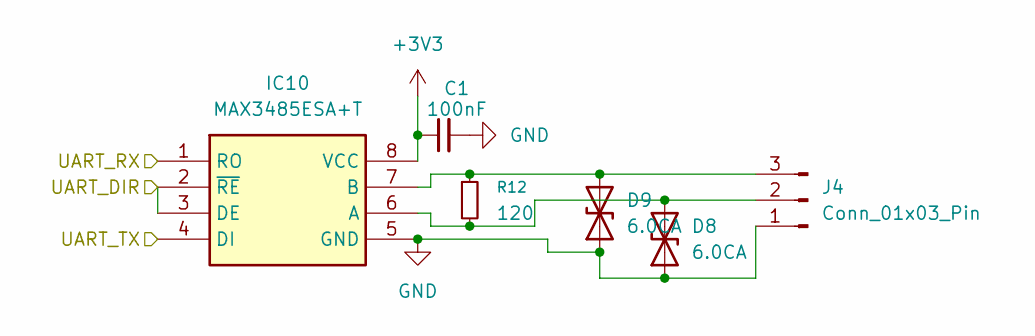
[picture p36: schematic communication.kicad_sch]

Parts:
C1: 100nF; C_0402_1005Metric
D8, D9: 6.0CA; D_SMA
IC10: MAX3485ESA+T; SOIC127P600X175-8N; Mouser Part Number 700-MAX3485ESAT
J4: Conn_01x03_Pin; JST_PH_B3B-PH-K_1x03_P2.00mm_Vertical
R12: 120; R_0402_1005Metric

Connections:
+3V3: C1.1, IC10.8 (VCC); also elsewhere on the board
/FPGA_Core/FPGA_TX3: IC10.4 (DI); also elsewhere on the board
/FPGA_Core/FPGA_TX4: IC10.1 (RO); also elsewhere on the board
/FPGA_Core/FPGA_TX80: IC10.2 (~RE), IC10.3 (DE); also elsewhere on the board
GND: C1.2, D8.1 (A1), D9.1 (A1), IC10.5 (GND), J4.1; also elsewhere on the board
unnamed: D8.2 (A2), IC10.6 (A), J4.2, R12.2
unnamed: D9.2 (A2), IC10.7 (B), J4.3, R12.1

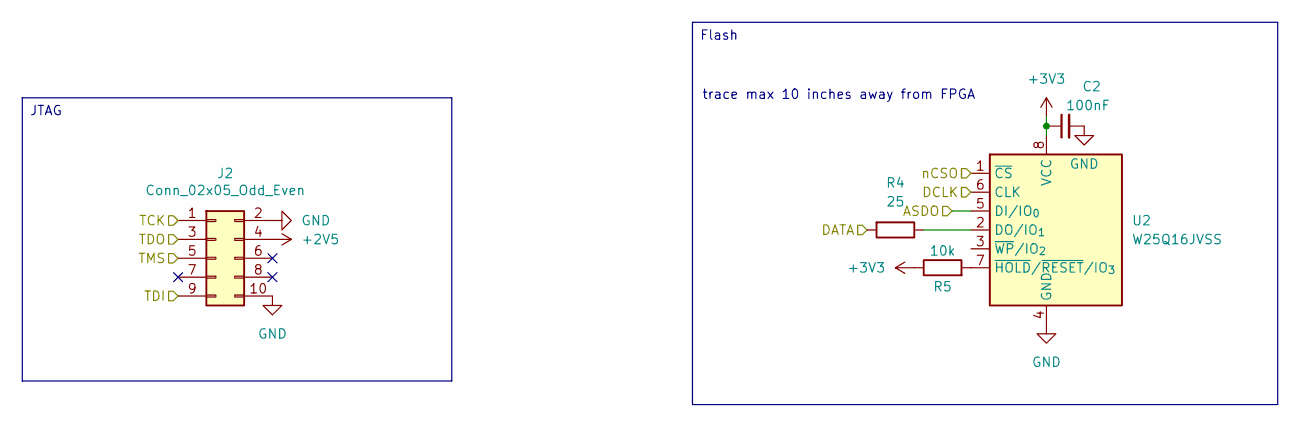
[picture p37: schematic config.kicad_sch]

Parts:
C2: 100nF; C_0402_1005Metric
J2: Conn_02x05_Odd_Even; IDC-Header_2x05_P2.54mm_Vertical
R4: 25; R_0402_1005Metric
R5: 10k; R_0402_1005Metric
U2: W25Q16JVSS; SOIC-8_5.3x5.3mm_P1.27mm

Connections:
+2V5: J2.4; also elsewhere on the board
+3V3: C2.1, R5.1, U2.8 (VCC); also elsewhere on the board
/Configuration/ASDO: U2.5 (DI/IO_{0}); also elsewhere on the board
/Configuration/DATA: R4.2; also elsewhere on the board
/Configuration/DCLK: U2.6 (CLK); also elsewhere on the board
/Configuration/TCK: J2.1; also elsewhere on the board
/Configuration/TDI: J2.9; also elsewhere on the board
/Configuration/TDO: J2.3; also elsewhere on the board
/Configuration/TMS: J2.5; also elsewhere on the board
/Configuration/nCSO: U2.1 (~CS); also elsewhere on the board
GND: C2.2, J2.2, J2.10, U2.4 (GND); also elsewhere on the board
unnamed: R4.1, U2.2 (DO/IO_{1})
unnamed: R5.2, U2.7 (~HOLD/~RESET/IO_{3})

Notes on the sheet:
trace max 10 inches away from FPGA
Flash
JTAG

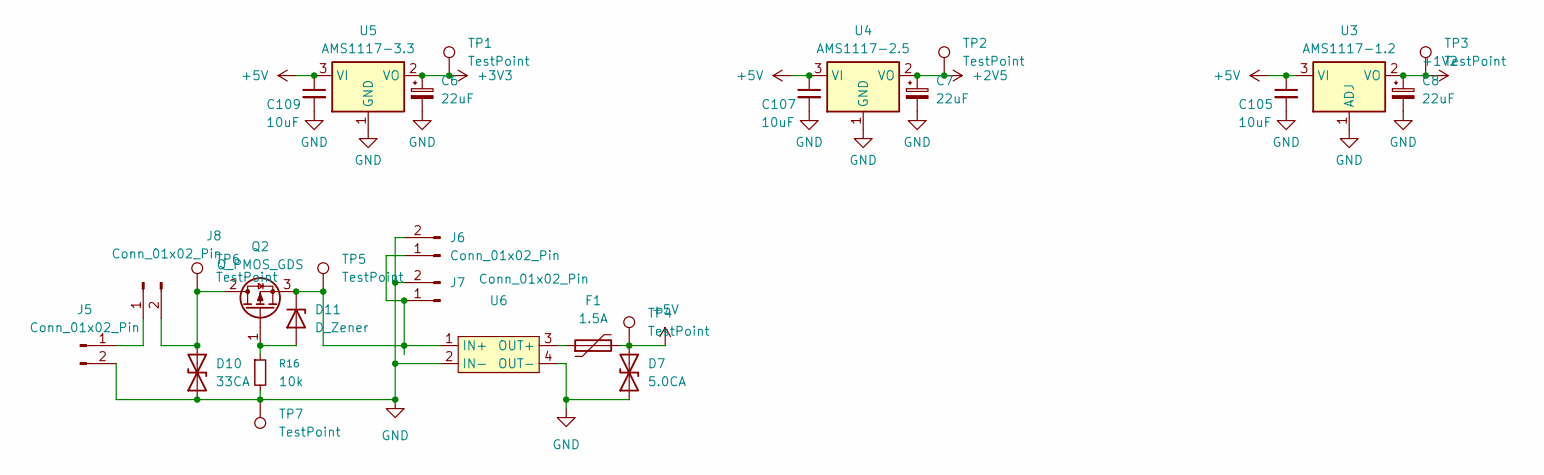
[picture p38: schematic power_management.kicad_sch]

Parts:
C6, C7, C8: 22uF; CP_EIA-3216-18_Kemet-A
C105, C107, C109: 10uF; C_0402_1005Metric
D7: 5.0CA; D_SMA
D10: 33CA; D_SMC
D11: D_Zener; D_SOD-323F
F1: 1.5A; Fuse_1206_3216Metric
J5, J6, J7, J8: Conn_01x02_Pin; JST_VH_B2P-VH-B_1x02_P3.96mm_Vertical
Q2: Q_PMOS_GDS; TO-252-2
R16: 10k; R_0402_1005Metric
TP1, TP2, TP3, TP4, TP5, TP6, TP7: TestPoint; TestPoint_Pad_D1.0mm
U3: AMS1117-1.2; SOT-223-3_TabPin2
U4: AMS1117-2.5; SOT-223-3_TabPin2
U5: AMS1117-3.3; SOT-223-3_TabPin2
U6: 4050S_Buck_Converter_Module

Connections:
+1V2: C8.1, TP3.1, U3.2 (VO); also elsewhere on the board
+2V5: C7.1, TP2.1, U4.2 (VO); also elsewhere on the board
+3V3: C6.1, TP1.1, U5.2 (VO); also elsewhere on the board
+5V: C105.1, C107.1, C109.1, D7.2 (A2), F1.2, TP4.1, U3.3 (VI), U4.3 (VI), U5.3 (VI); also elsewhere on the board
GND: C6.2, C7.2, C8.2, C105.2, C107.2, C109.2, D7.1 (A1), D10.1 (A1), J5.2, J6.2, J7.2, R16.2, TP7.1, U3.1 (ADJ), U4.1 (GND), U5.1 (GND), U6.2 (IN-), U6.4 (OUT-); also elsewhere on the board
unnamed: D10.2 (A2), J8.2, Q2.2 (D), TP6.1
unnamed: D11.2 (A), Q2.1 (G), R16.1
unnamed: D11.1 (K), J6.1, J7.1, Q2.3 (S), TP5.1, U6.1 (IN+)
unnamed: J5.1, J8.1
unnamed: F1.1, U6.3 (OUT+)

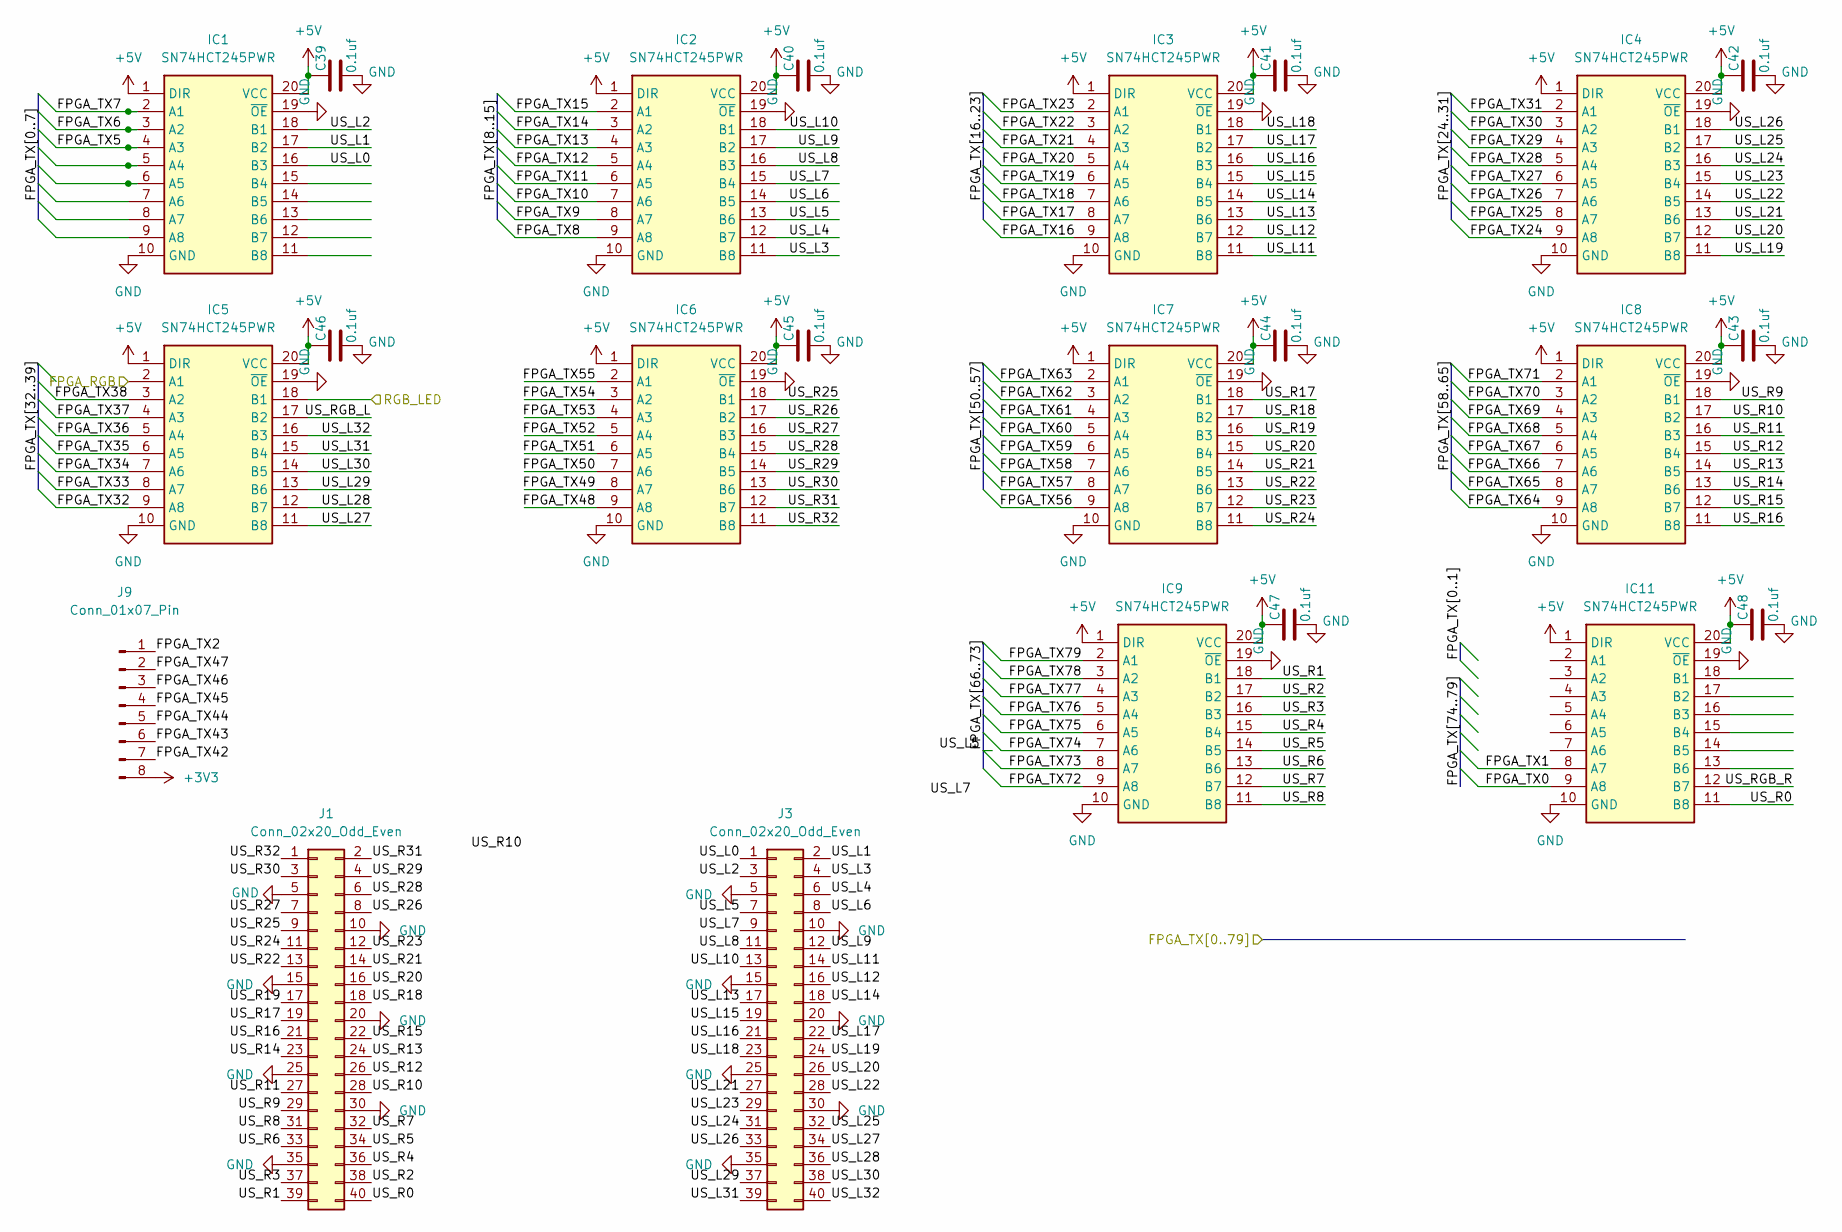
[picture p39: schematic io_interface.kicad_sch]

Parts:
C39, C40, C41, C42, C43, C44, C45, C46, C47, C48: 0.1uf; C_0402_1005Metric
IC1, IC2, IC3, IC4, IC5, IC6, IC7, IC8, IC9, IC11: SN74HCT245PWR; SOP65P640X120-20N; Mouser Part Number 595-SN74HCT245PWR
J1, J3: Conn_02x20_Odd_Even; IDC-Header_2x20_P2.54mm_Vertical
J9: Conn_01x07_Pin; PinHeader_2x04_P2.54mm_Vertical

Connections:
+3V3: J9.8; also elsewhere on the board
+5V: C39.1, C40.1, C41.1, C42.1, C43.1, C44.1, C45.1, C46.1, C47.1, C48.1, IC1.1 (DIR), IC1.20 (VCC), IC2.1 (DIR), IC2.20 (VCC), IC3.1 (DIR), IC3.20 (VCC), IC4.1 (DIR), IC4.20 (VCC), IC5.1 (DIR), IC5.20 (VCC), IC6.1 (DIR), IC6.20 (VCC), IC7.1 (DIR), IC7.20 (VCC), IC8.1 (DIR), IC8.20 (VCC), IC9.1 (DIR), IC9.20 (VCC), IC11.1 (DIR), IC11.20 (VCC); also elsewhere on the board
/FPGA_Core/FPGA_TX0: IC11.9 (A8); also elsewhere on the board
/FPGA_Core/FPGA_TX1: IC11.8 (A7); also elsewhere on the board
/FPGA_Core/FPGA_TX2: J9.1; also elsewhere on the board
/FPGA_Core/FPGA_TX5: IC1.4 (A3); also elsewhere on the board
/FPGA_Core/FPGA_TX6: IC1.3 (A2); also elsewhere on the board
/FPGA_Core/FPGA_TX7: IC1.2 (A1); also elsewhere on the board
/FPGA_Core/FPGA_TX8: IC2.9 (A8); also elsewhere on the board
/FPGA_Core/FPGA_TX9: IC2.8 (A7); also elsewhere on the board
/FPGA_Core/FPGA_TX10: IC2.7 (A6); also elsewhere on the board
/FPGA_Core/FPGA_TX11: IC2.6 (A5); also elsewhere on the board
/FPGA_Core/FPGA_TX12: IC2.5 (A4); also elsewhere on the board
/FPGA_Core/FPGA_TX13: IC2.4 (A3); also elsewhere on the board
/FPGA_Core/FPGA_TX14: IC2.3 (A2); also elsewhere on the board
/FPGA_Core/FPGA_TX15: IC2.2 (A1); also elsewhere on the board
/FPGA_Core/FPGA_TX16: IC3.9 (A8); also elsewhere on the board
/FPGA_Core/FPGA_TX17: IC3.8 (A7); also elsewhere on the board
/FPGA_Core/FPGA_TX18: IC3.7 (A6); also elsewhere on the board
/FPGA_Core/FPGA_TX19: IC3.6 (A5); also elsewhere on the board
/FPGA_Core/FPGA_TX20: IC3.5 (A4); also elsewhere on the board
/FPGA_Core/FPGA_TX21: IC3.4 (A3); also elsewhere on the board
/FPGA_Core/FPGA_TX22: IC3.3 (A2); also elsewhere on the board
/FPGA_Core/FPGA_TX23: IC3.2 (A1); also elsewhere on the board
/FPGA_Core/FPGA_TX24: IC4.9 (A8); also elsewhere on the board
/FPGA_Core/FPGA_TX25: IC4.8 (A7); also elsewhere on the board
/FPGA_Core/FPGA_TX26: IC4.7 (A6); also elsewhere on the board
/FPGA_Core/FPGA_TX27: IC4.6 (A5); also elsewhere on the board
/FPGA_Core/FPGA_TX28: IC4.5 (A4); also elsewhere on the board
/FPGA_Core/FPGA_TX29: IC4.4 (A3); also elsewhere on the board
/FPGA_Core/FPGA_TX30: IC4.3 (A2); also elsewhere on the board
/FPGA_Core/FPGA_TX31: IC4.2 (A1); also elsewhere on the board
/FPGA_Core/FPGA_TX32: IC5.9 (A8); also elsewhere on the board
/FPGA_Core/FPGA_TX33: IC5.8 (A7); also elsewhere on the board
/FPGA_Core/FPGA_TX34: IC5.7 (A6); also elsewhere on the board
/FPGA_Core/FPGA_TX35: IC5.6 (A5); also elsewhere on the board
/FPGA_Core/FPGA_TX36: IC5.5 (A4); also elsewhere on the board
/FPGA_Core/FPGA_TX37: IC5.4 (A3); also elsewhere on the board
/FPGA_Core/FPGA_TX38: IC5.3 (A2); also elsewhere on the board
/FPGA_Core/FPGA_TX39: IC5.2 (A1); also elsewhere on the board
/FPGA_Core/FPGA_TX42: J9.7; also elsewhere on the board
/FPGA_Core/FPGA_TX43: J9.6; also elsewhere on the board
/FPGA_Core/FPGA_TX44: J9.5; also elsewhere on the board
/FPGA_Core/FPGA_TX45: J9.4; also elsewhere on the board
/FPGA_Core/FPGA_TX46: J9.3; also elsewhere on the board
/FPGA_Core/FPGA_TX47: J9.2; also elsewhere on the board
/FPGA_Core/FPGA_TX48: IC6.9 (A8); also elsewhere on the board
/FPGA_Core/FPGA_TX49: IC6.8 (A7); also elsewhere on the board
/FPGA_Core/FPGA_TX50: IC6.7 (A6); also elsewhere on the board
/FPGA_Core/FPGA_TX51: IC6.6 (A5); also elsewhere on the board
/FPGA_Core/FPGA_TX52: IC6.5 (A4); also elsewhere on the board
/FPGA_Core/FPGA_TX53: IC6.4 (A3); also elsewhere on the board
/FPGA_Core/FPGA_TX54: IC6.3 (A2); also elsewhere on the board
/FPGA_Core/FPGA_TX55: IC6.2 (A1); also elsewhere on the board
/FPGA_Core/FPGA_TX56: IC7.9 (A8); also elsewhere on the board
/FPGA_Core/FPGA_TX57: IC7.8 (A7); also elsewhere on the board
/FPGA_Core/FPGA_TX58: IC7.7 (A6); also elsewhere on the board
/FPGA_Core/FPGA_TX59: IC7.6 (A5); also elsewhere on the board
/FPGA_Core/FPGA_TX60: IC7.5 (A4); also elsewhere on the board
/FPGA_Core/FPGA_TX61: IC7.4 (A3); also elsewhere on the board
/FPGA_Core/FPGA_TX62: IC7.3 (A2); also elsewhere on the board
/FPGA_Core/FPGA_TX63: IC7.2 (A1); also elsewhere on the board
/FPGA_Core/FPGA_TX64: IC8.9 (A8); also elsewhere on the board
/FPGA_Core/FPGA_TX65: IC8.8 (A7); also elsewhere on the board
/FPGA_Core/FPGA_TX66: IC8.7 (A6); also elsewhere on the board
/FPGA_Core/FPGA_TX67: IC8.6 (A5); also elsewhere on the board
/FPGA_Core/FPGA_TX68: IC8.5 (A4); also elsewhere on the board
/FPGA_Core/FPGA_TX69: IC8.4 (A3); also elsewhere on the board
/FPGA_Core/FPGA_TX70: IC8.3 (A2); also elsewhere on the board
/FPGA_Core/FPGA_TX71: IC8.2 (A1); also elsewhere on the board
/FPGA_Core/FPGA_TX72: IC9.9 (A8); also elsewhere on the board
/FPGA_Core/FPGA_TX73: IC9.8 (A7); also elsewhere on the board
/FPGA_Core/FPGA_TX74: IC9.7 (A6); also elsewhere on the board
/FPGA_Core/FPGA_TX75: IC9.6 (A5); also elsewhere on the board
/FPGA_Core/FPGA_TX76: IC9.5 (A4); also elsewhere on the board
/FPGA_Core/FPGA_TX77: IC9.4 (A3); also elsewhere on the board
/FPGA_Core/FPGA_TX78: IC9.3 (A2); also elsewhere on the board
/FPGA_Core/FPGA_TX79: IC9.2 (A1); also elsewhere on the board
/IO_Interface/RGB_LED: IC5.18 (B1); also elsewhere on the board
/IO_Interface/US_L0: IC1.16 (B3), J3.1
/IO_Interface/US_L1: IC1.17 (B2), J3.2
/IO_Interface/US_L2: IC1.18 (B1), J3.3
/IO_Interface/US_L3: IC2.11 (B8), J3.4
/IO_Interface/US_L4: IC2.12 (B7), J3.6
/IO_Interface/US_L5: IC2.13 (B6), J3.7
/IO_Interface/US_L6: IC2.14 (B5), J3.8
/IO_Interface/US_L7: IC2.15 (B4), J3.9
/IO_Interface/US_L8: IC2.16 (B3), J3.11
/IO_Interface/US_L9: IC2.17 (B2), J3.12
/IO_Interface/US_L10: IC2.18 (B1), J3.13
/IO_Interface/US_L11: IC3.11 (B8), J3.14
/IO_Interface/US_L12: IC3.12 (B7), J3.16
/IO_Interface/US_L13: IC3.13 (B6), J3.17
/IO_Interface/US_L14: IC3.14 (B5), J3.18
/IO_Interface/US_L15: IC3.15 (B4), J3.19
/IO_Interface/US_L16: IC3.16 (B3), J3.21
/IO_Interface/US_L17: IC3.17 (B2), J3.22
/IO_Interface/US_L18: IC3.18 (B1), J3.23
/IO_Interface/US_L19: IC4.11 (B8), J3.24
/IO_Interface/US_L20: IC4.12 (B7), J3.26
/IO_Interface/US_L21: IC4.13 (B6), J3.27
/IO_Interface/US_L22: IC4.14 (B5), J3.28
/IO_Interface/US_L23: IC4.15 (B4), J3.29
/IO_Interface/US_L24: IC4.16 (B3), J3.31
/IO_Interface/US_L25: IC4.17 (B2), J3.32
/IO_Interface/US_L26: IC4.18 (B1), J3.33
/IO_Interface/US_L27: IC5.11 (B8), J3.34
/IO_Interface/US_L28: IC5.12 (B7), J3.36
/IO_Interface/US_L29: IC5.13 (B6), J3.37
/IO_Interface/US_L30: IC5.14 (B5), J3.38
/IO_Interface/US_L31: IC5.15 (B4), J3.39
/IO_Interface/US_L32: IC5.16 (B3), J3.40
/IO_Interface/US_R0: IC11.11 (B8), J1.40
/IO_Interface/US_R1: IC9.18 (B1), J1.39
/IO_Interface/US_R2: IC9.17 (B2), J1.38
/IO_Interface/US_R3: IC9.16 (B3), J1.37
/IO_Interface/US_R4: IC9.15 (B4), J1.36
/IO_Interface/US_R5: IC9.14 (B5), J1.34
/IO_Interface/US_R6: IC9.13 (B6), J1.33
/IO_Interface/US_R7: IC9.12 (B7), J1.32
/IO_Interface/US_R8: IC9.11 (B8), J1.31
/IO_Interface/US_R9: IC8.18 (B1), J1.29
/IO_Interface/US_R10: IC8.17 (B2), J1.28
/IO_Interface/US_R11: IC8.16 (B3), J1.27
/IO_Interface/US_R12: IC8.15 (B4), J1.26
/IO_Interface/US_R13: IC8.14 (B5), J1.24
/IO_Interface/US_R14: IC8.13 (B6), J1.23
/IO_Interface/US_R15: IC8.12 (B7), J1.22
/IO_Interface/US_R16: IC8.11 (B8), J1.21
/IO_Interface/US_R17: IC7.18 (B1), J1.19
/IO_Interface/US_R18: IC7.17 (B2), J1.18
/IO_Interface/US_R19: IC7.16 (B3), J1.17
/IO_Interface/US_R20: IC7.15 (B4), J1.16
/IO_Interface/US_R21: IC7.14 (B5), J1.14
/IO_Interface/US_R22: IC7.13 (B6), J1.13
/IO_Interface/US_R23: IC7.12 (B7), J1.12
/IO_Interface/US_R24: IC7.11 (B8), J1.11
/IO_Interface/US_R25: IC6.18 (B1), J1.9
/IO_Interface/US_R26: IC6.17 (B2), J1.8
/IO_Interface/US_R27: IC6.16 (B3), J1.7
/IO_Interface/US_R28: IC6.15 (B4), J1.6
/IO_Interface/US_R29: IC6.14 (B5), J1.4
/IO_Interface/US_R30: IC6.13 (B6), J1.3
/IO_Interface/US_R31: IC6.12 (B7), J1.2
/IO_Interface/US_R32: IC6.11 (B8), J1.1
/IO_Interface/US_RGB_L: IC5.17 (B2)
/IO_Interface/US_RGB_R: IC11.12 (B7)
GND: C39.2, C40.2, C41.2, C42.2, C43.2, C44.2, C45.2, C46.2, C47.2, C48.2, IC1.10 (GND), IC1.19 (~OE), IC2.10 (GND), IC2.19 (~OE), IC3.10 (GND), IC3.19 (~OE), IC4.10 (GND), IC4.19 (~OE), IC5.10 (GND), IC5.19 (~OE), IC6.10 (GND), IC6.19 (~OE), IC7.10 (GND), IC7.19 (~OE), IC8.10 (GND), IC8.19 (~OE), IC9.10 (GND), IC9.19 (~OE), IC11.10 (GND), IC11.19 (~OE), J1.5, J1.10, J1.15, J1.20, J1.25, J1.30, J1.35, J3.5, J3.10, J3.15, J3.20, J3.25, J3.30, J3.35; also elsewhere on the board
