guomingloo/planar-acoustic-gripper/Electrical/AcousticGripper_MotherboardV1/AcousticGripper_MotherboardV1.kicad_pcb

## KiCad design Electrical/AcousticGripper_MotherboardV1/AcousticGripper_MotherboardV1.kicad_pcb (continued)

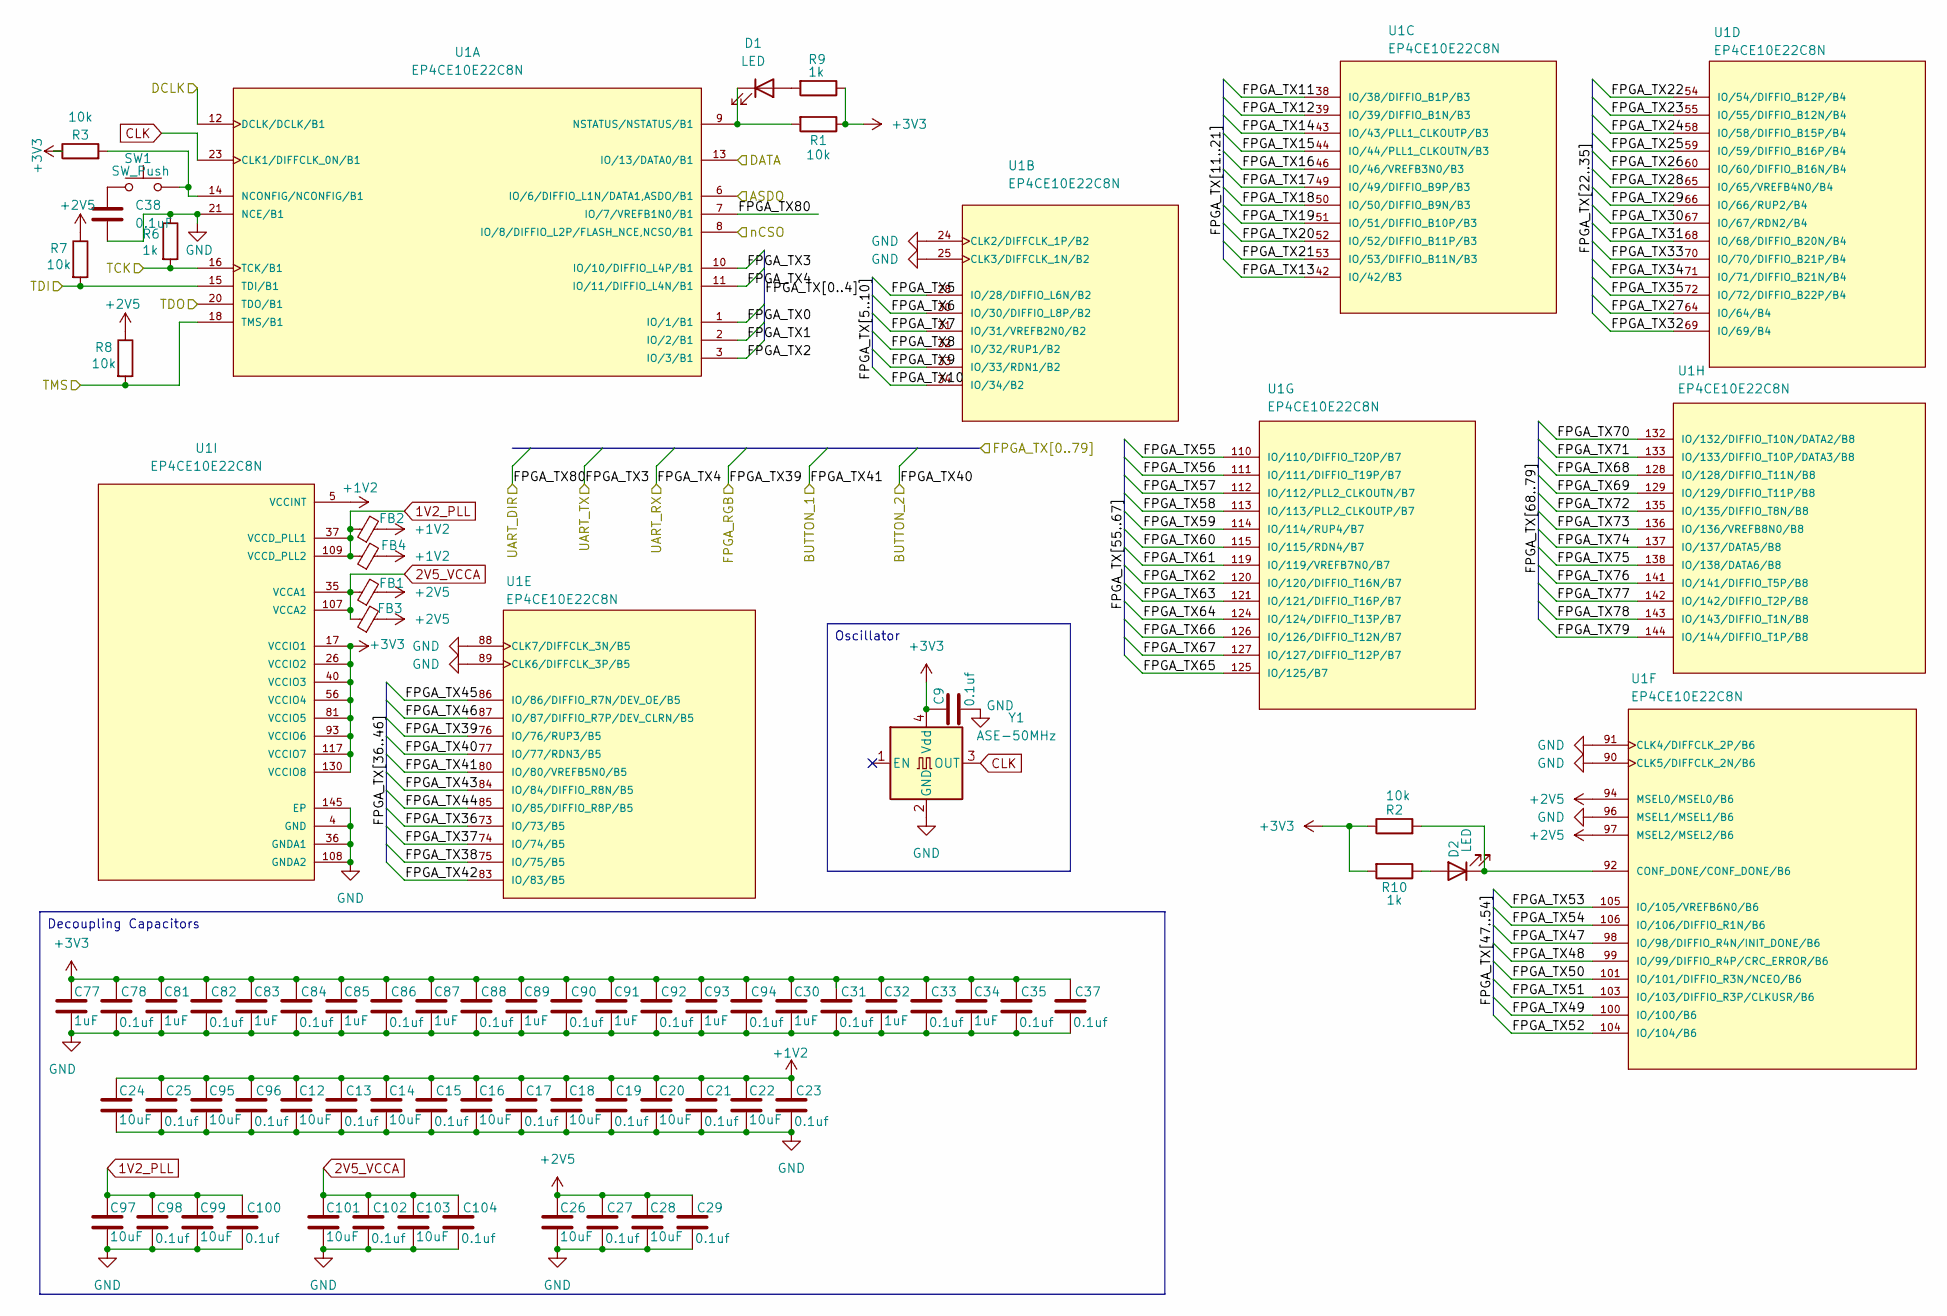
[picture p40: schematic fpga_core.kicad_sch]

Parts:
C9, C13, C15, C17, C19, C21, C23, C25, C27, C29, C31, C33, C35, C37, C78, C82, C84, C86, C88, C90, C92, C94, C96, C98, C100, C102, C104: 0.1uf; C_0402_1005Metric
C12, C14, C16, C18, C20, C22, C24, C26, C28, C95, C97, C99, C101, C103: 10uF; C_0402_1005Metric
C30, C32, C34, C77, C81, C83, C85, C87, C89, C91, C93: 1uF; C_0402_1005Metric
C38: 0.1uF; C_0402_1005Metric
D1, D2: LED; LED_D3.0mm
FB1, FB2, FB3, FB4: FerriteBead_Small; L_0402_1005Metric
R1, R2, R3, R7, R8: 10k; R_0402_1005Metric
R6, R9, R10: 1k; R_0402_1005Metric
SW1: SW_Push; SW_Push_SPST_NO_Alps_SKRK
U1: EP4CE10E22C8N; QFP50P2200X2200X165-145N
Y1: ASE-50MHz; Oscillator_SMD_Abracon_ASE-4Pin_3.2x2.5mm

Connections:
1V2_PLL: C97.1, C98.1, C99.1, C100.1, FB2.1, FB4.1, U1.37 (VCCD_PLL1), U1.109 (VCCD_PLL2)
2V5_VCCA: C101.1, C102.1, C103.1, C104.1, FB1.1, FB3.1, U1.35 (VCCA1), U1.107 (VCCA2)
+1V2: C12.1, C13.1, C14.1, C15.1, C16.1, C17.1, C18.1, C19.1, C20.1, C21.1, C22.1, C23.1, C24.1, C25.1, C95.1, C96.1, FB2.2, FB4.2, U1.5 (VCCINT), U1.29 (VCCINT), U1.45 (VCCINT), U1.61 (VCCINT), U1.78 (VCCINT), U1.102 (VCCINT), U1.116 (VCCINT), U1.134 (VCCINT); also elsewhere on the board
+2V5: C26.1, C27.1, C28.1, C29.1, FB1.2, FB3.2, R7.1, R8.1, U1.94 (MSEL0/MSEL0/B6), U1.97 (MSEL2/MSEL2/B6); also elsewhere on the board
+3V3: C9.1, C30.1, C31.1, C32.1, C33.1, C34.1, C35.1, C37.1, C77.1, C78.1, C81.1, C82.1, C83.1, C84.1, C85.1, C86.1, C87.1, C88.1, C89.1, C90.1, C91.1, C92.1, C93.1, C94.1, R1.1, R2.1, R3.1, R9.1, R10.2, U1.17 (VCCIO1), U1.26 (VCCIO2), U1.40 (VCCIO3), U1.47 (VCCIO3), U1.56 (VCCIO4), U1.62 (VCCIO4), U1.81 (VCCIO5), U1.93 (VCCIO6), U1.117 (VCCIO7), U1.122 (VCCIO7), U1.130 (VCCIO8), U1.139 (VCCIO8), Y1.4 (Vdd); also elsewhere on the board
/Configuration/ASDO: U1.6 (IO/6/DIFFIO_L1N/DATA1,ASDO/B1); also elsewhere on the board
/Configuration/DATA: U1.13 (IO/13/DATA0/B1); also elsewhere on the board
/Configuration/DCLK: U1.12 (DCLK/DCLK/B1); also elsewhere on the board
/Configuration/TCK: R6.2, U1.16 (TCK/B1); also elsewhere on the board
/Configuration/TDI: R7.2, U1.15 (TDI/B1); also elsewhere on the board
/Configuration/TDO: U1.20 (TDO/B1); also elsewhere on the board
/Configuration/TMS: R8.2, U1.18 (TMS/B1); also elsewhere on the board
/Configuration/nCSO: U1.8 (IO/8/DIFFIO_L2P/FLASH_NCE,NCSO/B1); also elsewhere on the board
/FPGA_Core/FPGA_TX0: U1.1 (IO/1/B1); also elsewhere on the board
/FPGA_Core/FPGA_TX1: U1.2 (IO/2/B1); also elsewhere on the board
/FPGA_Core/FPGA_TX2: U1.3 (IO/3/B1); also elsewhere on the board
/FPGA_Core/FPGA_TX3: U1.10 (IO/10/DIFFIO_L4P/B1); also elsewhere on the board
/FPGA_Core/FPGA_TX4: U1.11 (IO/11/DIFFIO_L4N/B1); also elsewhere on the board
/FPGA_Core/FPGA_TX5: U1.28 (IO/28/DIFFIO_L6N/B2); also elsewhere on the board
/FPGA_Core/FPGA_TX6: U1.30 (IO/30/DIFFIO_L8P/B2); also elsewhere on the board
/FPGA_Core/FPGA_TX7: U1.31 (IO/31/VREFB2N0/B2); also elsewhere on the board
/FPGA_Core/FPGA_TX8: U1.32 (IO/32/RUP1/B2); also elsewhere on the board
/FPGA_Core/FPGA_TX9: U1.33 (IO/33/RDN1/B2); also elsewhere on the board
/FPGA_Core/FPGA_TX10: U1.34 (IO/34/B2); also elsewhere on the board
/FPGA_Core/FPGA_TX11: U1.38 (IO/38/DIFFIO_B1P/B3); also elsewhere on the board
/FPGA_Core/FPGA_TX12: U1.39 (IO/39/DIFFIO_B1N/B3); also elsewhere on the board
/FPGA_Core/FPGA_TX13: U1.42 (IO/42/B3); also elsewhere on the board
/FPGA_Core/FPGA_TX14: U1.43 (IO/43/PLL1_CLKOUTP/B3); also elsewhere on the board
/FPGA_Core/FPGA_TX15: U1.44 (IO/44/PLL1_CLKOUTN/B3); also elsewhere on the board
/FPGA_Core/FPGA_TX16: U1.46 (IO/46/VREFB3N0/B3); also elsewhere on the board
/FPGA_Core/FPGA_TX17: U1.49 (IO/49/DIFFIO_B9P/B3); also elsewhere on the board
/FPGA_Core/FPGA_TX18: U1.50 (IO/50/DIFFIO_B9N/B3); also elsewhere on the board
/FPGA_Core/FPGA_TX19: U1.51 (IO/51/DIFFIO_B10P/B3); also elsewhere on the board
/FPGA_Core/FPGA_TX20: U1.52 (IO/52/DIFFIO_B11P/B3); also elsewhere on the board
/FPGA_Core/FPGA_TX21: U1.53 (IO/53/DIFFIO_B11N/B3); also elsewhere on the board
/FPGA_Core/FPGA_TX22: U1.54 (IO/54/DIFFIO_B12P/B4); also elsewhere on the board
/FPGA_Core/FPGA_TX23: U1.55 (IO/55/DIFFIO_B12N/B4); also elsewhere on the board
/FPGA_Core/FPGA_TX24: U1.58 (IO/58/DIFFIO_B15P/B4); also elsewhere on the board
/FPGA_Core/FPGA_TX25: U1.59 (IO/59/DIFFIO_B16P/B4); also elsewhere on the board
/FPGA_Core/FPGA_TX26: U1.60 (IO/60/DIFFIO_B16N/B4); also elsewhere on the board
/FPGA_Core/FPGA_TX27: U1.64 (IO/64/B4); also elsewhere on the board
/FPGA_Core/FPGA_TX28: U1.65 (IO/65/VREFB4N0/B4); also elsewhere on the board
/FPGA_Core/FPGA_TX29: U1.66 (IO/66/RUP2/B4); also elsewhere on the board
/FPGA_Core/FPGA_TX30: U1.67 (IO/67/RDN2/B4); also elsewhere on the board
/FPGA_Core/FPGA_TX31: U1.68 (IO/68/DIFFIO_B20N/B4); also elsewhere on the board
/FPGA_Core/FPGA_TX32: U1.69 (IO/69/B4); also elsewhere on the board
/FPGA_Core/FPGA_TX33: U1.70 (IO/70/DIFFIO_B21P/B4); also elsewhere on the board
/FPGA_Core/FPGA_TX34: U1.71 (IO/71/DIFFIO_B21N/B4); also elsewhere on the board
/FPGA_Core/FPGA_TX35: U1.72 (IO/72/DIFFIO_B22P/B4); also elsewhere on the board
/FPGA_Core/FPGA_TX36: U1.73 (IO/73/B5); also elsewhere on the board
/FPGA_Core/FPGA_TX37: U1.74 (IO/74/B5); also elsewhere on the board
/FPGA_Core/FPGA_TX38: U1.75 (IO/75/B5); also elsewhere on the board
/FPGA_Core/FPGA_TX39: U1.76 (IO/76/RUP3/B5); also elsewhere on the board
/FPGA_Core/FPGA_TX40: U1.77 (IO/77/RDN3/B5); also elsewhere on the board
/FPGA_Core/FPGA_TX41: U1.80 (IO/80/VREFB5N0/B5); also elsewhere on the board
/FPGA_Core/FPGA_TX42: U1.83 (IO/83/B5); also elsewhere on the board
/FPGA_Core/FPGA_TX43: U1.84 (IO/84/DIFFIO_R8N/B5); also elsewhere on the board
/FPGA_Core/FPGA_TX44: U1.85 (IO/85/DIFFIO_R8P/B5); also elsewhere on the board
/FPGA_Core/FPGA_TX45: U1.86 (IO/86/DIFFIO_R7N/DEV_OE/B5); also elsewhere on the board
/FPGA_Core/FPGA_TX46: U1.87 (IO/87/DIFFIO_R7P/DEV_CLRN/B5); also elsewhere on the board
/FPGA_Core/FPGA_TX47: U1.98 (IO/98/DIFFIO_R4N/INIT_DONE/B6); also elsewhere on the board
/FPGA_Core/FPGA_TX48: U1.99 (IO/99/DIFFIO_R4P/CRC_ERROR/B6); also elsewhere on the board
/FPGA_Core/FPGA_TX49: U1.100 (IO/100/B6); also elsewhere on the board
/FPGA_Core/FPGA_TX50: U1.101 (IO/101/DIFFIO_R3N/NCEO/B6); also elsewhere on the board
/FPGA_Core/FPGA_TX51: U1.103 (IO/103/DIFFIO_R3P/CLKUSR/B6); also elsewhere on the board
/FPGA_Core/FPGA_TX52: U1.104 (IO/104/B6); also elsewhere on the board
/FPGA_Core/FPGA_TX53: U1.105 (IO/105/VREFB6N0/B6); also elsewhere on the board
/FPGA_Core/FPGA_TX54: U1.106 (IO/106/DIFFIO_R1N/B6); also elsewhere on the board
/FPGA_Core/FPGA_TX55: U1.110 (IO/110/DIFFIO_T20P/B7); also elsewhere on the board
/FPGA_Core/FPGA_TX56: U1.111 (IO/111/DIFFIO_T19P/B7); also elsewhere on the board
/FPGA_Core/FPGA_TX57: U1.112 (IO/112/PLL2_CLKOUTN/B7); also elsewhere on the board
/FPGA_Core/FPGA_TX58: U1.113 (IO/113/PLL2_CLKOUTP/B7); also elsewhere on the board
/FPGA_Core/FPGA_TX59: U1.114 (IO/114/RUP4/B7); also elsewhere on the board
/FPGA_Core/FPGA_TX60: U1.115 (IO/115/RDN4/B7); also elsewhere on the board
/FPGA_Core/FPGA_TX61: U1.119 (IO/119/VREFB7N0/B7); also elsewhere on the board
/FPGA_Core/FPGA_TX62: U1.120 (IO/120/DIFFIO_T16N/B7); also elsewhere on the board
/FPGA_Core/FPGA_TX63: U1.121 (IO/121/DIFFIO_T16P/B7); also elsewhere on the board
/FPGA_Core/FPGA_TX64: U1.124 (IO/124/DIFFIO_T13P/B7); also elsewhere on the board
/FPGA_Core/FPGA_TX65: U1.125 (IO/125/B7); also elsewhere on the board
/FPGA_Core/FPGA_TX66: U1.126 (IO/126/DIFFIO_T12N/B7); also elsewhere on the board
/FPGA_Core/FPGA_TX67: U1.127 (IO/127/DIFFIO_T12P/B7); also elsewhere on the board
/FPGA_Core/FPGA_TX68: U1.128 (IO/128/DIFFIO_T11N/B8); also elsewhere on the board
/FPGA_Core/FPGA_TX69: U1.129 (IO/129/DIFFIO_T11P/B8); also elsewhere on the board
/FPGA_Core/FPGA_TX70: U1.132 (IO/132/DIFFIO_T10N/DATA2/B8); also elsewhere on the board
/FPGA_Core/FPGA_TX71: U1.133 (IO/133/DIFFIO_T10P/DATA3/B8); also elsewhere on the board
/FPGA_Core/FPGA_TX72: U1.135 (IO/135/DIFFIO_T8N/B8); also elsewhere on the board
/FPGA_Core/FPGA_TX73: U1.136 (IO/136/VREFB8N0/B8); also elsewhere on the board
/FPGA_Core/FPGA_TX74: U1.137 (IO/137/DATA5/B8); also elsewhere on the board
/FPGA_Core/FPGA_TX75: U1.138 (IO/138/DATA6/B8); also elsewhere on the board
/FPGA_Core/FPGA_TX76: U1.141 (IO/141/DIFFIO_T5P/B8); also elsewhere on the board
/FPGA_Core/FPGA_TX77: U1.142 (IO/142/DIFFIO_T2P/B8); also elsewhere on the board
/FPGA_Core/FPGA_TX78: U1.143 (IO/143/DIFFIO_T1N/B8); also elsewhere on the board
/FPGA_Core/FPGA_TX79: U1.144 (IO/144/DIFFIO_T1P/B8); also elsewhere on the board
/FPGA_Core/FPGA_TX80: U1.7 (IO/7/VREFB1N0/B1); also elsewhere on the board
CLK: U1.23 (CLK1/DIFFCLK_0N/B1), Y1.3 (OUT)
GND: C9.2, C12.2, C13.2, C14.2, C15.2, C16.2, C17.2, C18.2, C19.2, C20.2, C21.2, C22.2, C23.2, C24.2, C25.2, C26.2, C27.2, C28.2, C29.2, C30.2, C31.2, C32.2, C33.2, C34.2, C35.2, C37.2, C38.2, C77.2, C78.2, C81.2, C82.2, C83.2, C84.2, C85.2, C86.2, C87.2, C88.2, C89.2, C90.2, C91.2, C92.2, C93.2, C94.2, C95.2, C96.2, C97.2, C98.2, C99.2, C100.2, C101.2, C102.2, C103.2, C104.2, R6.1, U1.4 (GND), U1.19 (GND), U1.21 (NCE/B1), U1.22 (GND), U1.24 (CLK2/DIFFCLK_1P/B2), U1.25 (CLK3/DIFFCLK_1N/B2), U1.27 (GND), U1.36 (GNDA1), U1.41 (GND), U1.48 (GND), U1.57 (GND), U1.63 (GND), U1.79 (GND), U1.82 (GND), U1.88 (CLK7/DIFFCLK_3N/B5), U1.89 (CLK6/DIFFCLK_3P/B5), U1.90 (CLK5/DIFFCLK_2N/B6), U1.91 (CLK4/DIFFCLK_2P/B6), U1.95 (GND), U1.96 (MSEL1/MSEL1/B6), U1.108 (GNDA2), U1.118 (GND), U1.123 (GND), U1.131 (GND), U1.140 (GND), U1.145 (EP), Y1.2 (GND); also elsewhere on the board
unnamed: C38.1, SW1.1
unnamed: D1.2 (A), R9.2
unnamed: D1.1 (K), R1.2, U1.9 (NSTATUS/NSTATUS/B1)
unnamed: D2.2 (A), R10.1
unnamed: D2.1 (K), R2.2, U1.92 (CONF_DONE/CONF_DONE/B6)
unnamed: R3.2, SW1.2, U1.14 (NCONFIG/NCONFIG/B1)

Notes on the sheet:
Oscillator
Decoupling Capacitors

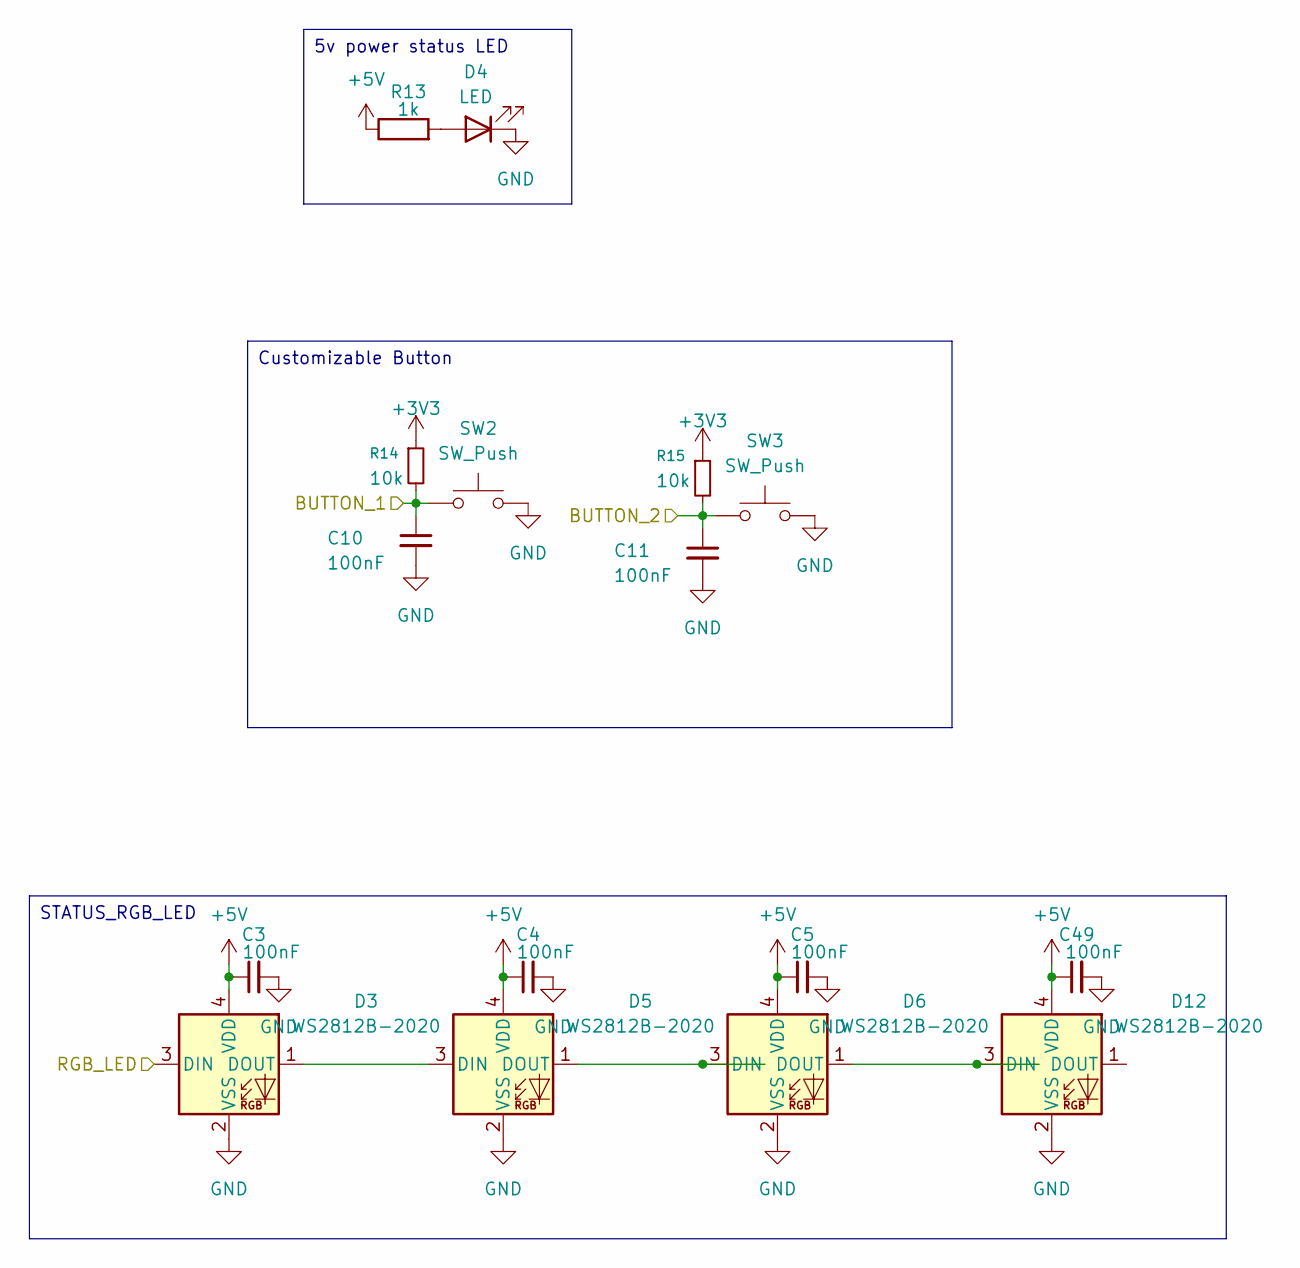
[picture p41: schematic user_interface.kicad_sch]

Parts:
C3, C4, C5, C10, C11, C49: 100nF; C_0402_1005Metric
D3, D5, D6, D12: WS2812B-2020; LED_WS2812B-2020_PLCC4_2.0x2.0mm
D4: LED; LED_D3.0mm
R13: 1k; R_0402_1005Metric
R14, R15: 10k; R_0402_1005Metric
SW2, SW3: SW_Push; SW_Push_SPST_NO_Alps_SKRK

Connections:
+3V3: R14.1, R15.1; also elsewhere on the board
+5V: C3.1, C4.1, C5.1, C49.1, D3.4 (VDD), D5.4 (VDD), D6.4 (VDD), D12.4 (VDD), R13.1; also elsewhere on the board
/FPGA_Core/FPGA_TX40: C11.1, R15.2, SW3.1; also elsewhere on the board
/FPGA_Core/FPGA_TX41: C10.1, R14.2, SW2.1; also elsewhere on the board
/IO_Interface/RGB_LED: D3.3 (DIN); also elsewhere on the board
GND: C3.2, C4.2, C5.2, C10.2, C11.2, C49.2, D3.2 (VSS), D4.1 (K), D5.2 (VSS), D6.2 (VSS), D12.2 (VSS), SW2.2, SW3.2; also elsewhere on the board
unnamed: D3.1 (DOUT), D5.3 (DIN)
unnamed: D4.2 (A), R13.2
unnamed: D5.1 (DOUT), D6.3 (DIN)
unnamed: D6.1 (DOUT), D12.3 (DIN)

Notes on the sheet:
Customizable Button
STATUS_RGB_LED
5v power status LED

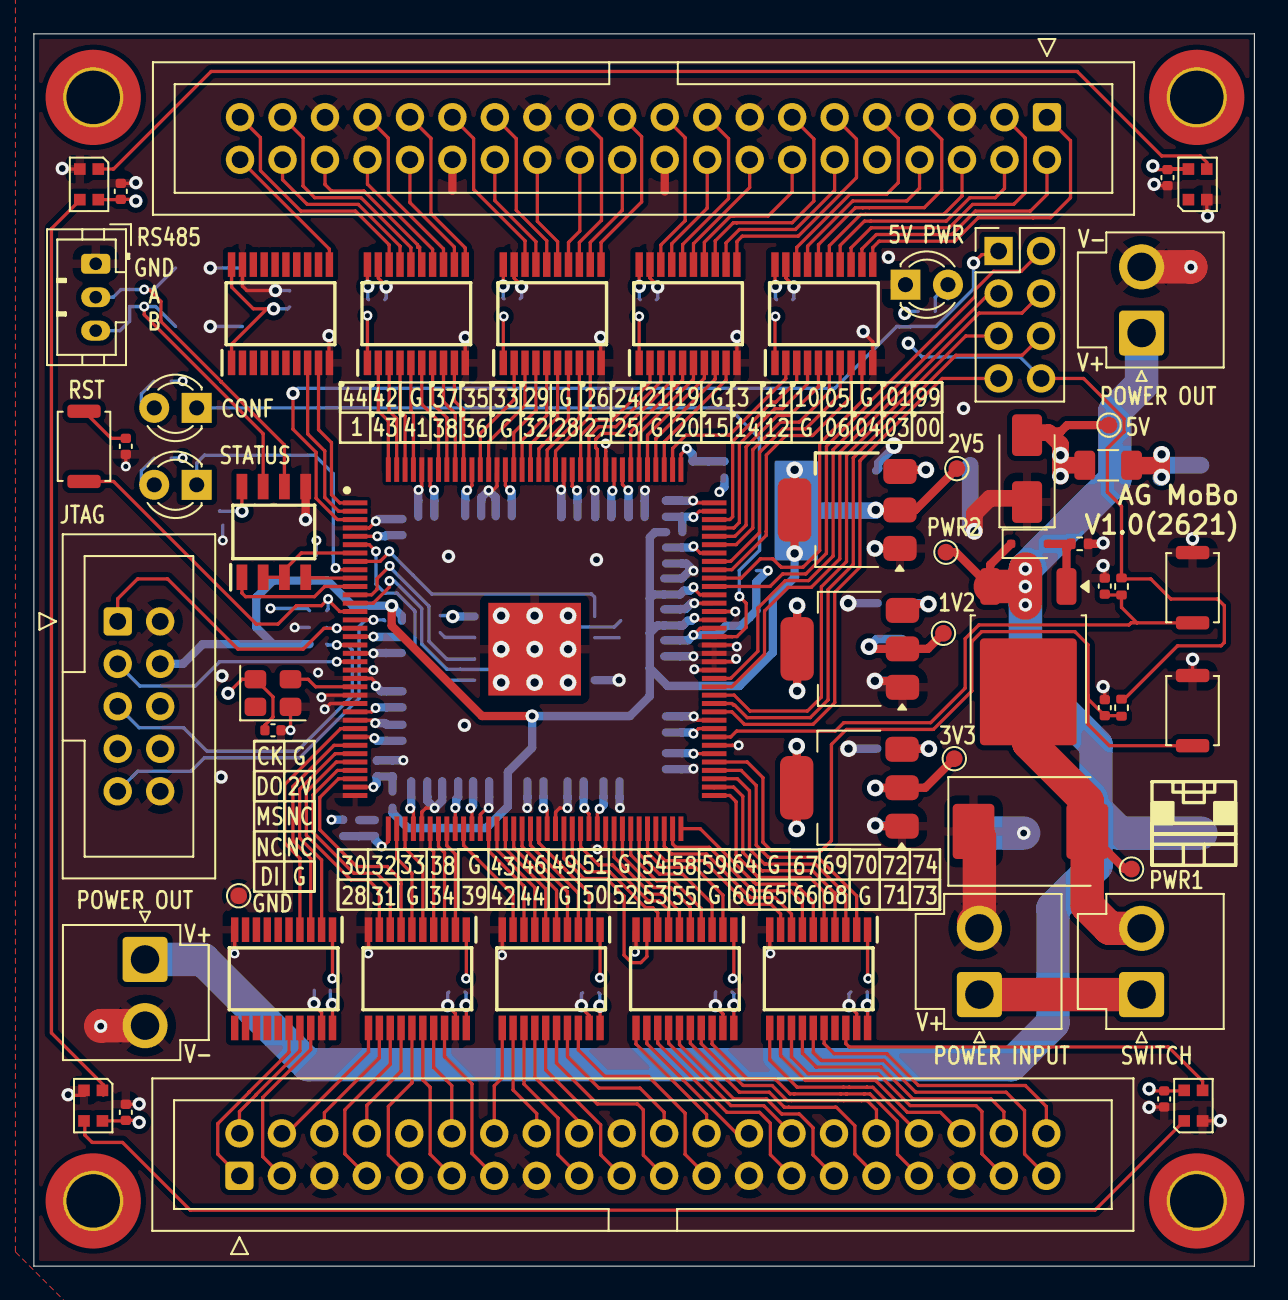
[picture p42: board AcousticGripper_MotherboardV1.kicad_pcb from above]

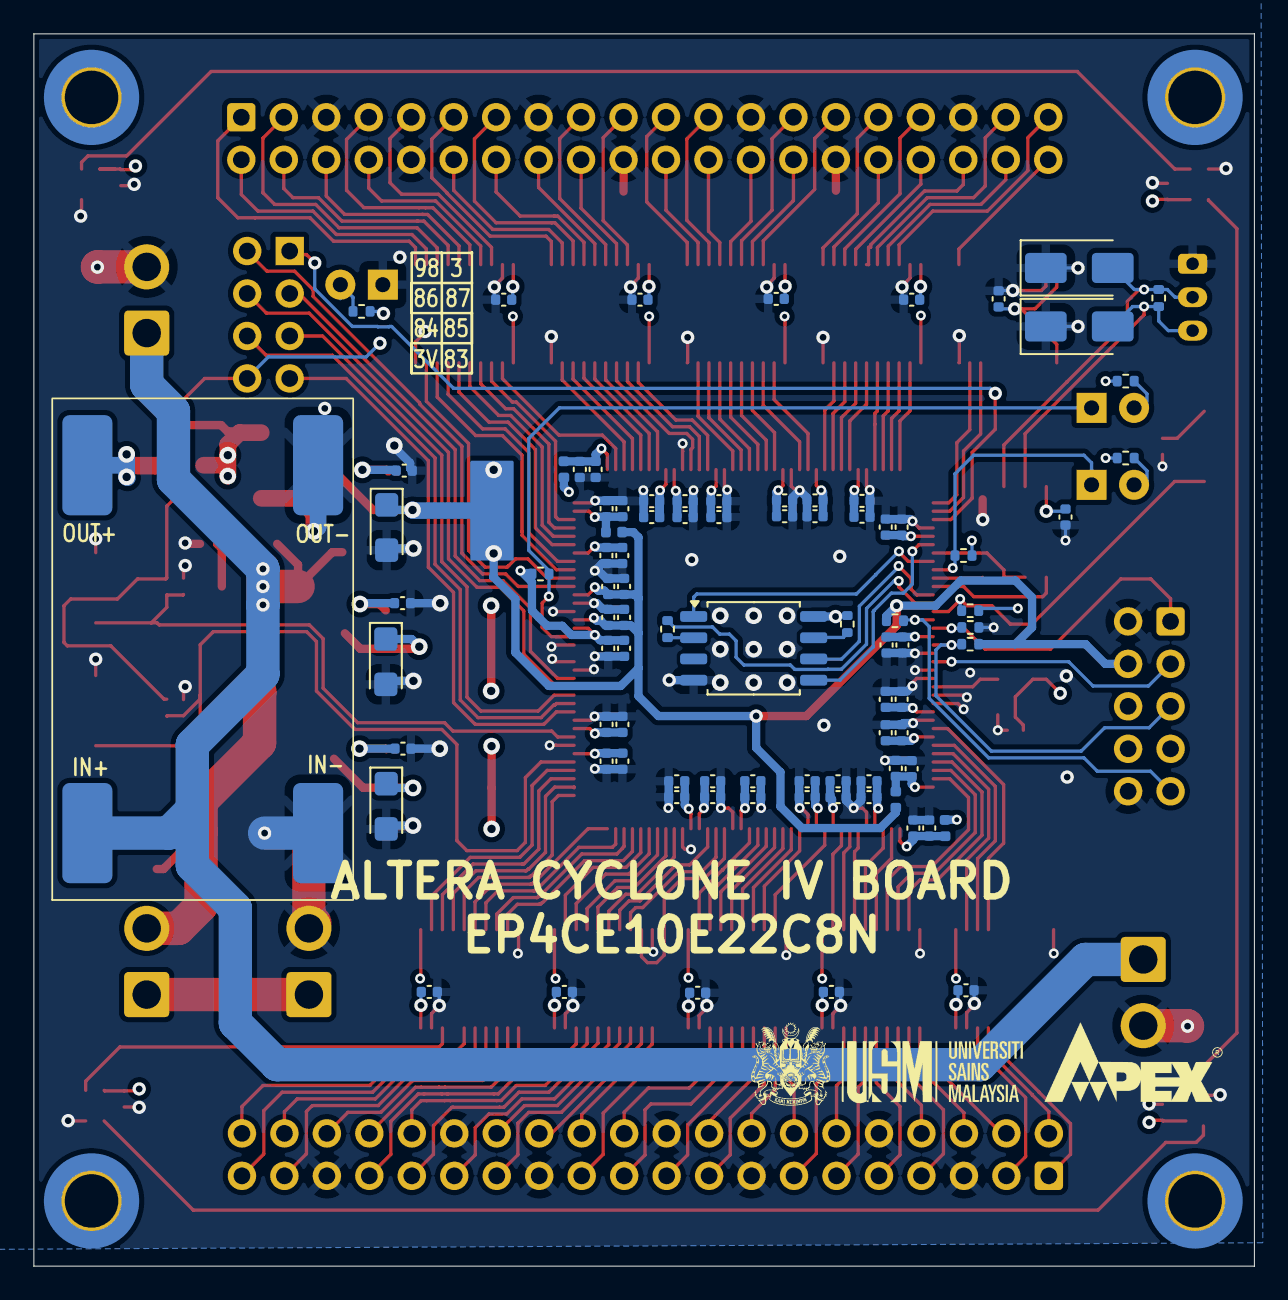
[picture p43: board AcousticGripper_MotherboardV1.kicad_pcb from below]

Board: 4 copper layers, 73.0 x 73.7 mm, 147 parts (89 on the bottom side), 183 nets.
