guomingloo/planar-acoustic-gripper/Electrical/BaseStationV1/BaseStationPart2/BaseStationPart2.kicad_pcb

## KiCad design Electrical/BaseStationV1/BaseStationPart2/BaseStationPart2.kicad_pcb (2026-07-02)

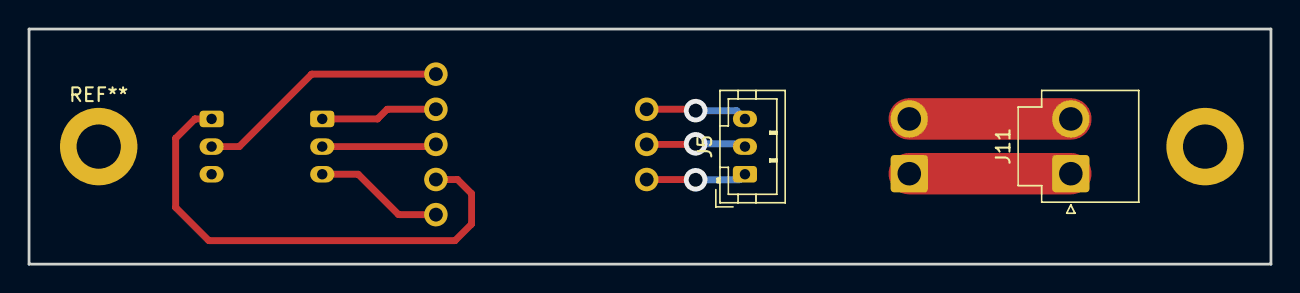
[picture p44: board BaseStationPart2.kicad_pcb from above]

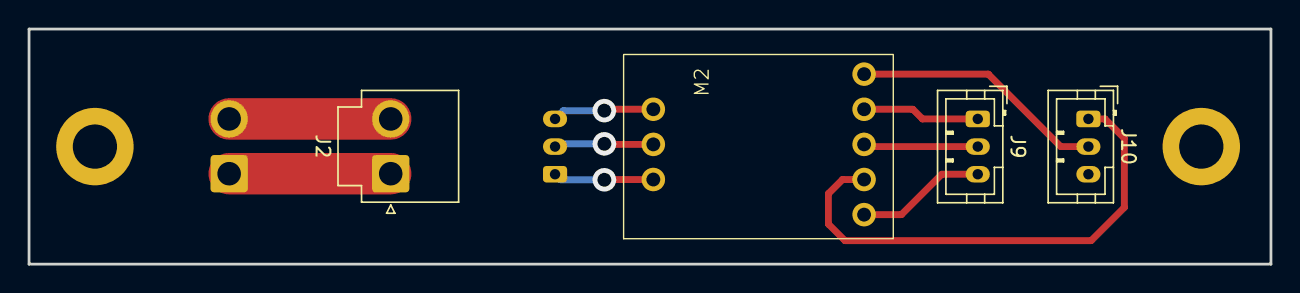
[picture p45: board BaseStationPart2.kicad_pcb from below]

Board: 2 copper layers, 89.8 x 17.0 mm, 6 parts (4 on the bottom side), 10 nets.

Parts:
J2, J11: Conn_01x02_Pin; JST_VH_B2P-VH-B_1x02_P3.96mm_Vertical
J5, J9, J10: Conn_01x03_Pin; JST_PH_B3B-PH-K_1x03_P2.00mm_Vertical
M2: MAX3485_Module

Connections:
+3V3: J10.1, M2.5 (VCC)
GND: J10.2, M2.8 (GND)
unnamed: J9.1, M2.7 (TX)
unnamed: J9.2, M2.6 (RX)
unnamed: J9.3, M2.4 (EN)
unnamed: J5.1, M2.1 (GND)
unnamed: J5.2, M2.2 (A)
unnamed: J5.3, M2.3 (B)
unnamed: J2.1, J11.1
unnamed: J2.2, J11.2
