guomingloo/planar-acoustic-gripper/Electrical/AcousticGripper_DaughterboardV1.1/AcousticGripper_DaughterboardV1.1.kicad_pcb

## KiCad design Electrical/AcousticGripper_DaughterboardV1.1/AcousticGripper_DaughterboardV1.1.kicad_pcb (2026-07-02)

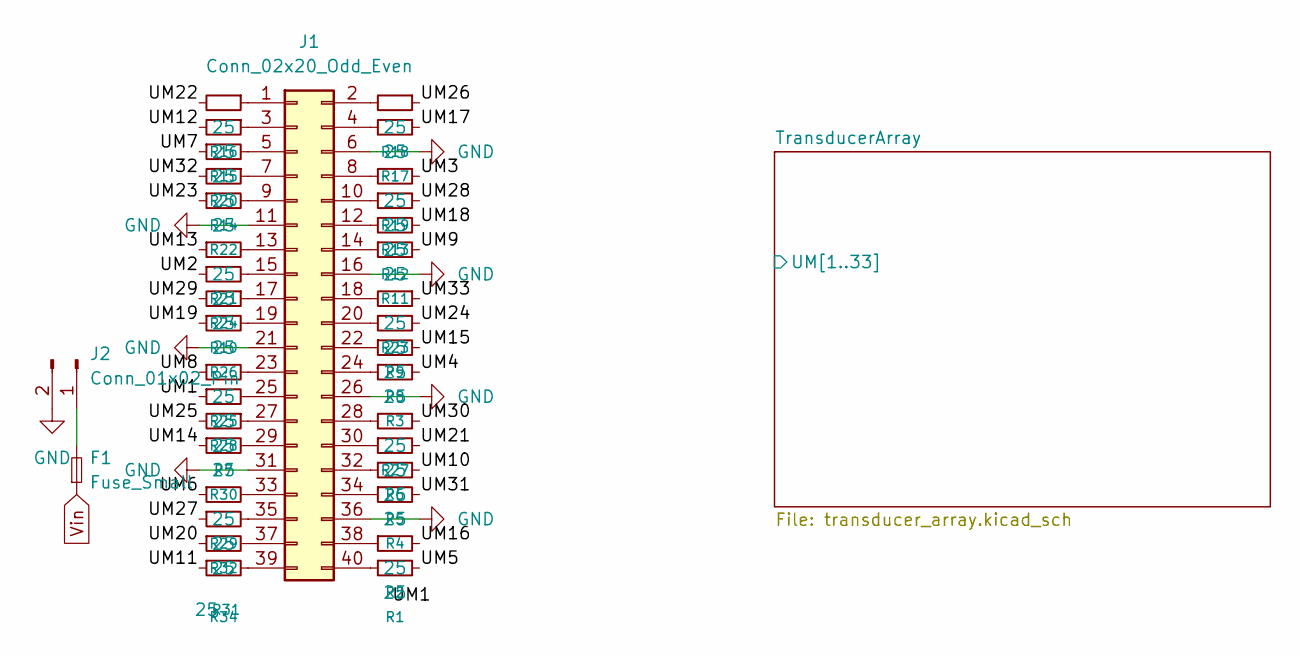
[picture p46: schematic AcousticGripper_DaughterboardV1.1.kicad_sch]

Parts:
F1: Fuse_Small; Fuse_Littelfuse-NANO2-451_453
J1: Conn_02x20_Odd_Even; IDC-Header_2x20_P2.54mm_Vertical
J2: Conn_01x02_Pin; JST_VH_B2P-VH-B_1x02_P3.96mm_Vertical
R1, R2, R3, R4, R5, R6, R7, R8, R9, R10, R11, R12, R13, R14, R15, R16, R17, R18, R19, R20, R21, R22, R23, R24, R25, R26, R27, R28, R29, R30, R31, R32, R34: 25; R_0402_1005Metric

Connections:
/TransducerArray/UM1: R28.1; also elsewhere on the board
/TransducerArray/UM2: R24.1; also elsewhere on the board
/TransducerArray/UM3: R19.1; also elsewhere on the board
/TransducerArray/UM4: R3.2; also elsewhere on the board
/TransducerArray/UM5: R1.2; also elsewhere on the board
/TransducerArray/UM6: R29.1; also elsewhere on the board
/TransducerArray/UM7: R20.1; also elsewhere on the board
/TransducerArray/UM8: R25.1; also elsewhere on the board
/TransducerArray/UM9: R11.2; also elsewhere on the board
/TransducerArray/UM10: R5.2; also elsewhere on the board
/TransducerArray/UM11: R34.1; also elsewhere on the board
/TransducerArray/UM12: R15.2; also elsewhere on the board
/TransducerArray/UM13: R21.1; also elsewhere on the board
/TransducerArray/UM14: R30.1; also elsewhere on the board
/TransducerArray/UM15: R8.2; also elsewhere on the board
/TransducerArray/UM16: R2.2; also elsewhere on the board
/TransducerArray/UM17: R17.1; also elsewhere on the board
/TransducerArray/UM18: R12.2; also elsewhere on the board
/TransducerArray/UM19: R26.1; also elsewhere on the board
/TransducerArray/UM20: R31.1; also elsewhere on the board
/TransducerArray/UM21: R6.2; also elsewhere on the board
/TransducerArray/UM22: R16.2; also elsewhere on the board
/TransducerArray/UM23: R22.1; also elsewhere on the board
/TransducerArray/UM24: R9.2; also elsewhere on the board
/TransducerArray/UM25: R7.2; also elsewhere on the board
/TransducerArray/UM26: R18.1; also elsewhere on the board
/TransducerArray/UM27: R32.1; also elsewhere on the board
/TransducerArray/UM28: R13.2; also elsewhere on the board
/TransducerArray/UM29: R10.2; also elsewhere on the board
/TransducerArray/UM30: R27.1; also elsewhere on the board
/TransducerArray/UM31: R4.2; also elsewhere on the board
/TransducerArray/UM32: R14.2; also elsewhere on the board
/TransducerArray/UM33: R23.1; also elsewhere on the board
GND: J1.6, J1.11, J1.16, J1.21, J1.26, J1.31, J1.36, J2.2; also elsewhere on the board
unnamed: J1.1, R16.1
unnamed: J1.2, R18.2
unnamed: J1.3, R15.1
unnamed: J1.4, R17.2
unnamed: J1.5, R20.2
unnamed: J1.7, R14.1
unnamed: J1.8, R19.2
unnamed: J1.9, R22.2
unnamed: J1.10, R13.1
unnamed: J1.12, R12.1
unnamed: J1.13, R21.2
unnamed: J1.14, R11.1
unnamed: J1.15, R24.2
unnamed: J1.17, R10.1
unnamed: J1.18, R23.2
unnamed: J1.19, R26.2
unnamed: J1.20, R9.1
unnamed: J1.22, R8.1
unnamed: J1.23, R25.2
unnamed: J1.24, R3.1
unnamed: J1.25, R28.2
unnamed: J1.27, R7.1
unnamed: J1.28, R27.2
unnamed: J1.29, R30.2
unnamed: J1.30, R6.1
unnamed: J1.32, R5.1
unnamed: J1.33, R29.2
unnamed: J1.34, R4.1
unnamed: J1.35, R32.2
unnamed: J1.37, R31.2
unnamed: J1.38, R2.1
unnamed: J1.39, R34.2
unnamed: J1.40, R1.1
unnamed: F1.2, J2.1
Vin: F1.1; also elsewhere on the board

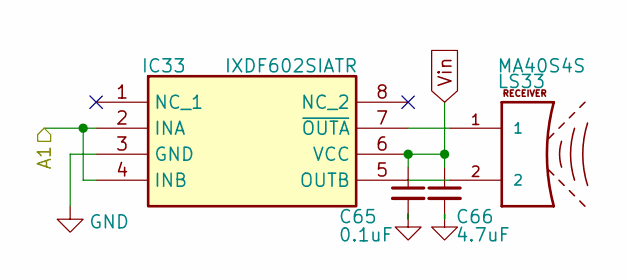
[picture p47: schematic ultrasonic_module.kicad_sch]

Parts:
C65: 0.1uF; C_0603_1608Metric_Pad1.08x0.95mm_HandSolder
C66: 4.7uF; C_0805_2012Metric_Pad1.18x1.45mm_HandSolder
IC33: IXDF602SIATR; IX4340N; Mouser Part Number 849-IXDF602SIATR
LS33: MA40S4S; XDCR_MA40S4S

Connections:
/TransducerArray/UM1: IC33.2 (INA), IC33.4 (INB); also elsewhere on the board
GND: C65.2, C66.2, IC33.3 (GND); also elsewhere on the board
unnamed: IC33.5 (OUTB), LS33.2
unnamed: IC33.7 (~OUTA), LS33.1
Vin: C65.1, C66.1, IC33.6 (VCC); also elsewhere on the board

Parts of its further copies:
C1, C3, C5, C7, C9, C11, C13, C15, C17, C19, C21, C23, C25, C27, C29, C31, C33, C35, C37, C39, C41, C43, C45, C47, C49, C51, C53, C55, C57, C59, C61, C63: 0.1uF; C_0603_1608Metric_Pad1.08x0.95mm_HandSolder
C2, C4, C6, C8, C10, C12, C14, C16, C18, C20, C22, C24, C26, C28, C30, C32, C34, C36, C38, C40, C42, C44, C46, C48, C50, C52, C54, C56, C58, C60, C62, C64: 4.7uF; C_0805_2012Metric_Pad1.18x1.45mm_HandSolder
IC1, IC2, IC3, IC4, IC5, IC6, IC7, IC8, IC9, IC10, IC11, IC12, IC13, IC14, IC15, IC16, IC17, IC18, IC19, IC20, IC21, IC22, IC23, IC24, IC25, IC26, IC27, IC28, IC29, IC30, IC31, IC32: IXDF602SIATR; IX4340N; Mouser Part Number 849-IXDF602SIATR
LS1, LS2, LS3, LS4, LS5, LS6, LS7, LS8, LS9, LS10, LS11, LS12, LS13, LS14, LS15, LS16, LS17, LS18, LS19, LS20, LS21, LS22, LS23, LS24, LS25, LS26, LS27, LS28, LS29, LS30, LS31, LS32: MA40S4S; XDCR_MA40S4S

Connections of its further copies:
/TransducerArray/UM2: IC2.2 (INA), IC2.4 (INB); also elsewhere on the board
/TransducerArray/UM3: IC1.2 (INA), IC1.4 (INB); also elsewhere on the board
/TransducerArray/UM4: IC3.2 (INA), IC3.4 (INB); also elsewhere on the board
/TransducerArray/UM5: IC5.2 (INA), IC5.4 (INB); also elsewhere on the board
/TransducerArray/UM6: IC4.2 (INA), IC4.4 (INB); also elsewhere on the board
/TransducerArray/UM7: IC6.2 (INA), IC6.4 (INB); also elsewhere on the board
/TransducerArray/UM8: IC8.2 (INA), IC8.4 (INB); also elsewhere on the board
/TransducerArray/UM9: IC7.2 (INA), IC7.4 (INB); also elsewhere on the board
/TransducerArray/UM10: IC9.2 (INA), IC9.4 (INB); also elsewhere on the board
/TransducerArray/UM11: IC10.2 (INA), IC10.4 (INB); also elsewhere on the board
/TransducerArray/UM12: IC11.2 (INA), IC11.4 (INB); also elsewhere on the board
/TransducerArray/UM13: IC12.2 (INA), IC12.4 (INB); also elsewhere on the board
/TransducerArray/UM14: IC14.2 (INA), IC14.4 (INB); also elsewhere on the board
/TransducerArray/UM15: IC13.2 (INA), IC13.4 (INB); also elsewhere on the board
/TransducerArray/UM16: IC15.2 (INA), IC15.4 (INB); also elsewhere on the board
/TransducerArray/UM17: IC16.2 (INA), IC16.4 (INB); also elsewhere on the board
/TransducerArray/UM18: IC17.2 (INA), IC17.4 (INB); also elsewhere on the board
/TransducerArray/UM19: IC18.2 (INA), IC18.4 (INB); also elsewhere on the board
/TransducerArray/UM20: IC20.2 (INA), IC20.4 (INB); also elsewhere on the board
/TransducerArray/UM21: IC19.2 (INA), IC19.4 (INB); also elsewhere on the board
/TransducerArray/UM22: IC21.2 (INA), IC21.4 (INB); also elsewhere on the board
/TransducerArray/UM23: IC22.2 (INA), IC22.4 (INB); also elsewhere on the board
/TransducerArray/UM24: IC23.2 (INA), IC23.4 (INB); also elsewhere on the board
/TransducerArray/UM25: IC24.2 (INA), IC24.4 (INB); also elsewhere on the board
/TransducerArray/UM26: IC26.2 (INA), IC26.4 (INB); also elsewhere on the board
/TransducerArray/UM27: IC25.2 (INA), IC25.4 (INB); also elsewhere on the board
/TransducerArray/UM28: IC27.2 (INA), IC27.4 (INB); also elsewhere on the board
/TransducerArray/UM29: IC28.2 (INA), IC28.4 (INB); also elsewhere on the board
/TransducerArray/UM30: IC29.2 (INA), IC29.4 (INB); also elsewhere on the board
/TransducerArray/UM31: IC30.2 (INA), IC30.4 (INB); also elsewhere on the board
/TransducerArray/UM32: IC31.2 (INA), IC31.4 (INB); also elsewhere on the board
/TransducerArray/UM33: IC32.2 (INA), IC32.4 (INB); also elsewhere on the board
GND: C1.2, C2.2, C3.2, C4.2, C5.2, C6.2, C7.2, C8.2, C9.2, C10.2, C11.2, C12.2, C13.2, C14.2, C15.2, C16.2, C17.2, C18.2, C19.2, C20.2, C21.2, C22.2, C23.2, C24.2, C25.2, C26.2, C27.2, C28.2, C29.2, C30.2, C31.2, C32.2, C33.2, C34.2, C35.2, C36.2, C37.2, C38.2, C39.2, C40.2, C41.2, C42.2, C43.2, C44.2, C45.2, C46.2, C47.2, C48.2, C49.2, C50.2, C51.2, C52.2, C53.2, C54.2, C55.2, C56.2, C57.2, C58.2, C59.2, C60.2, C61.2, C62.2, C63.2, C64.2, IC1.3 (GND), IC2.3 (GND), IC3.3 (GND), IC4.3 (GND), IC5.3 (GND), IC6.3 (GND), IC7.3 (GND), IC8.3 (GND), IC9.3 (GND), IC10.3 (GND), IC11.3 (GND), IC12.3 (GND), IC13.3 (GND), IC14.3 (GND), IC15.3 (GND), IC16.3 (GND), IC17.3 (GND), IC18.3 (GND), IC19.3 (GND), IC20.3 (GND), IC21.3 (GND), IC22.3 (GND), IC23.3 (GND), IC24.3 (GND), IC25.3 (GND), IC26.3 (GND), IC27.3 (GND), IC28.3 (GND), IC29.3 (GND), IC30.3 (GND), IC31.3 (GND), IC32.3 (GND); also elsewhere on the board
unnamed: IC1.5 (OUTB), LS1.2
unnamed: IC1.7 (~OUTA), LS1.1
unnamed: IC2.5 (OUTB), LS2.2
unnamed: IC2.7 (~OUTA), LS2.1
unnamed: IC3.5 (OUTB), LS3.2
unnamed: IC3.7 (~OUTA), LS3.1
unnamed: IC4.5 (OUTB), LS4.2
unnamed: IC4.7 (~OUTA), LS4.1
unnamed: IC5.5 (OUTB), LS5.2
unnamed: IC5.7 (~OUTA), LS5.1
unnamed: IC6.5 (OUTB), LS6.2
unnamed: IC6.7 (~OUTA), LS6.1
unnamed: IC7.5 (OUTB), LS7.2
unnamed: IC7.7 (~OUTA), LS7.1
unnamed: IC8.5 (OUTB), LS8.2
unnamed: IC8.7 (~OUTA), LS8.1
unnamed: IC9.5 (OUTB), LS9.2
unnamed: IC9.7 (~OUTA), LS9.1
unnamed: IC10.5 (OUTB), LS10.2
unnamed: IC10.7 (~OUTA), LS10.1
unnamed: IC11.5 (OUTB), LS11.2
unnamed: IC11.7 (~OUTA), LS11.1
unnamed: IC12.5 (OUTB), LS12.2
unnamed: IC12.7 (~OUTA), LS12.1
unnamed: IC13.5 (OUTB), LS13.2
unnamed: IC13.7 (~OUTA), LS13.1
unnamed: IC14.5 (OUTB), LS14.2
unnamed: IC14.7 (~OUTA), LS14.1
unnamed: IC15.5 (OUTB), LS15.2
unnamed: IC15.7 (~OUTA), LS15.1
unnamed: IC16.5 (OUTB), LS16.2
unnamed: IC16.7 (~OUTA), LS16.1
unnamed: IC17.5 (OUTB), LS17.2
unnamed: IC17.7 (~OUTA), LS17.1
unnamed: IC18.5 (OUTB), LS18.2
unnamed: IC18.7 (~OUTA), LS18.1
unnamed: IC19.5 (OUTB), LS19.2
unnamed: IC19.7 (~OUTA), LS19.1
unnamed: IC20.5 (OUTB), LS20.2
unnamed: IC20.7 (~OUTA), LS20.1
unnamed: IC21.5 (OUTB), LS21.2
unnamed: IC21.7 (~OUTA), LS21.1
unnamed: IC22.5 (OUTB), LS22.2
unnamed: IC22.7 (~OUTA), LS22.1
unnamed: IC23.5 (OUTB), LS23.2
unnamed: IC23.7 (~OUTA), LS23.1
unnamed: IC24.5 (OUTB), LS24.2
unnamed: IC24.7 (~OUTA), LS24.1
unnamed: IC25.5 (OUTB), LS25.2
unnamed: IC25.7 (~OUTA), LS25.1
unnamed: IC26.5 (OUTB), LS26.2
unnamed: IC26.7 (~OUTA), LS26.1
unnamed: IC27.5 (OUTB), LS27.2
unnamed: IC27.7 (~OUTA), LS27.1
unnamed: IC28.5 (OUTB), LS28.2
unnamed: IC28.7 (~OUTA), LS28.1
unnamed: IC29.5 (OUTB), LS29.2
unnamed: IC29.7 (~OUTA), LS29.1
unnamed: IC30.5 (OUTB), LS30.2
unnamed: IC30.7 (~OUTA), LS30.1
unnamed: IC31.5 (OUTB), LS31.2
unnamed: IC31.7 (~OUTA), LS31.1
unnamed: IC32.5 (OUTB), LS32.2
unnamed: IC32.7 (~OUTA), LS32.1
Vin: C1.1, C2.1, C3.1, C4.1, C5.1, C6.1, C7.1, C8.1, C9.1, C10.1, C11.1, C12.1, C13.1, C14.1, C15.1, C16.1, C17.1, C18.1, C19.1, C20.1, C21.1, C22.1, C23.1, C24.1, C25.1, C26.1, C27.1, C28.1, C29.1, C30.1, C31.1, C32.1, C33.1, C34.1, C35.1, C36.1, C37.1, C38.1, C39.1, C40.1, C41.1, C42.1, C43.1, C44.1, C45.1, C46.1, C47.1, C48.1, C49.1, C50.1, C51.1, C52.1, C53.1, C54.1, C55.1, C56.1, C57.1, C58.1, C59.1, C60.1, C61.1, C62.1, C63.1, C64.1, IC1.6 (VCC), IC2.6 (VCC), IC3.6 (VCC), IC4.6 (VCC), IC5.6 (VCC), IC6.6 (VCC), IC7.6 (VCC), IC8.6 (VCC), IC9.6 (VCC), IC10.6 (VCC), IC11.6 (VCC), IC12.6 (VCC), IC13.6 (VCC), IC14.6 (VCC), IC15.6 (VCC), IC16.6 (VCC), IC17.6 (VCC), IC18.6 (VCC), IC19.6 (VCC), IC20.6 (VCC), IC21.6 (VCC), IC22.6 (VCC), IC23.6 (VCC), IC24.6 (VCC), IC25.6 (VCC), IC26.6 (VCC), IC27.6 (VCC), IC28.6 (VCC), IC29.6 (VCC), IC30.6 (VCC), IC31.6 (VCC), IC32.6 (VCC); also elsewhere on the board
