guomingloo/planar-acoustic-gripper/Electrical/AcousticGripper_DaughterboardV1.1/AcousticGripper_DaughterboardV1.1.kicad_pcb

## KiCad design Electrical/AcousticGripper_DaughterboardV1.1/AcousticGripper_DaughterboardV1.1.kicad_pcb (continued)

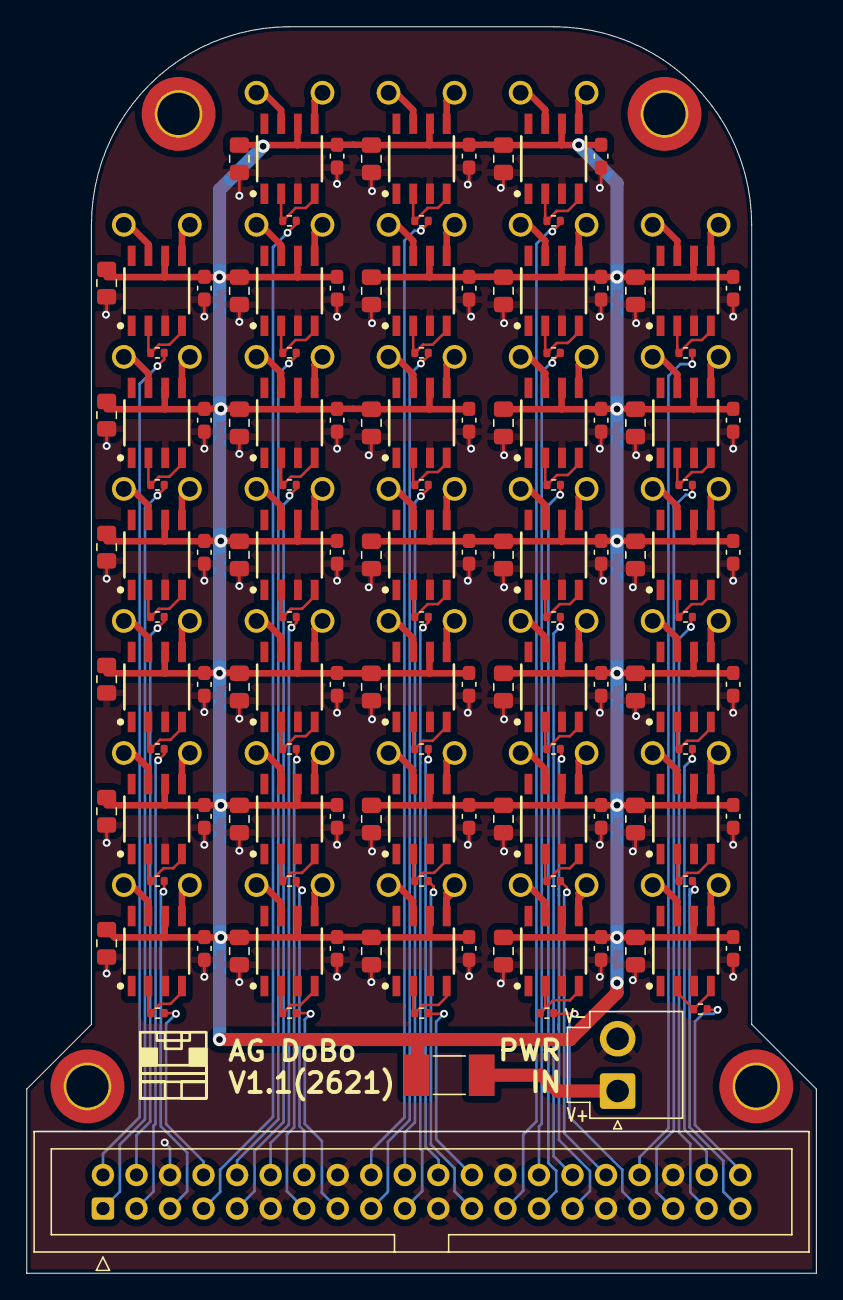
[picture p48: board AcousticGripper_DaughterboardV1.1.kicad_pcb from above]

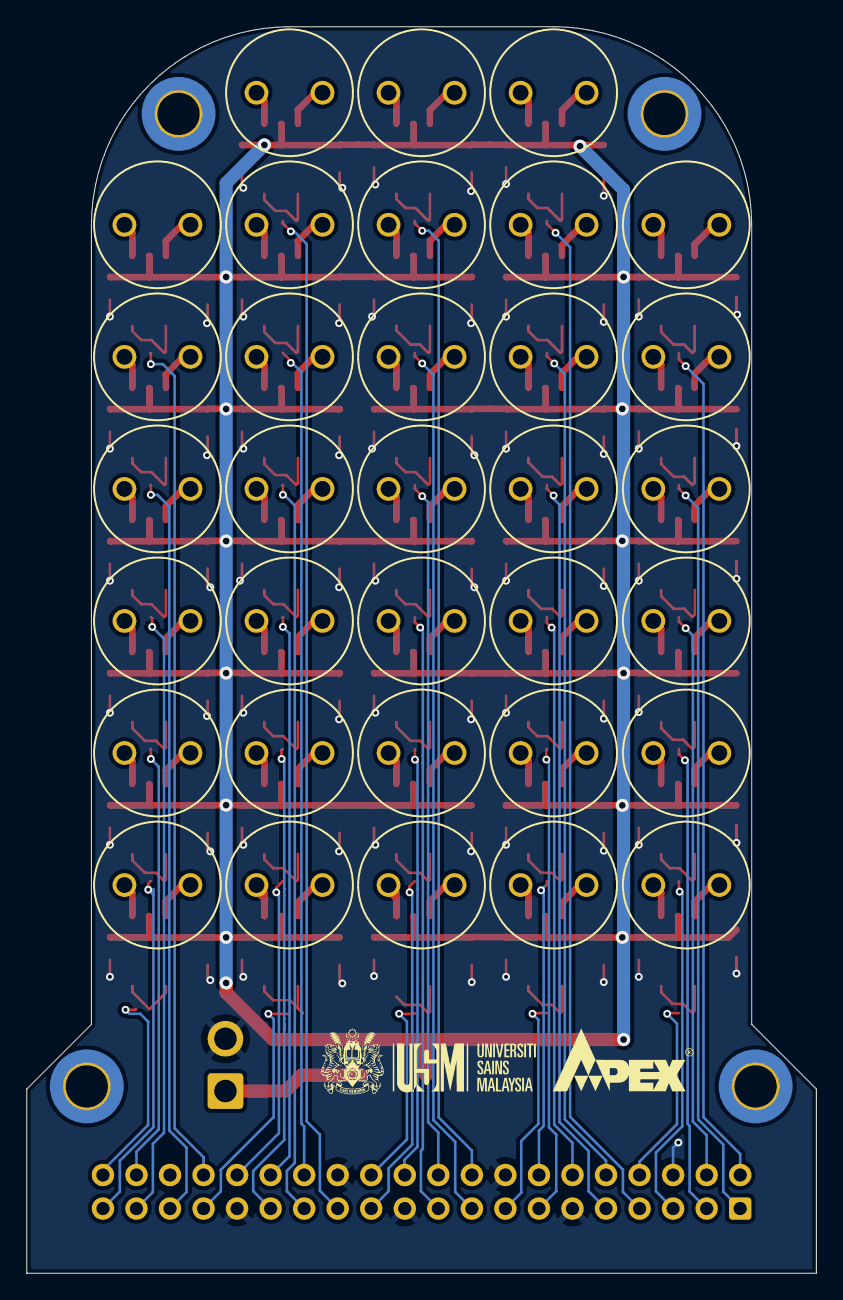
[picture p49: board AcousticGripper_DaughterboardV1.1.kicad_pcb from below]

Board: 2 copper layers, 59.8 x 94.4 mm, 168 parts (33 on the bottom side), 135 nets.
