guomingloo/planar-acoustic-gripper/Electrical/AcousticGripper/AcousticGripper.kicad_pcb

## KiCad design Electrical/AcousticGripper/AcousticGripper.kicad_pcb (2026-07-02)

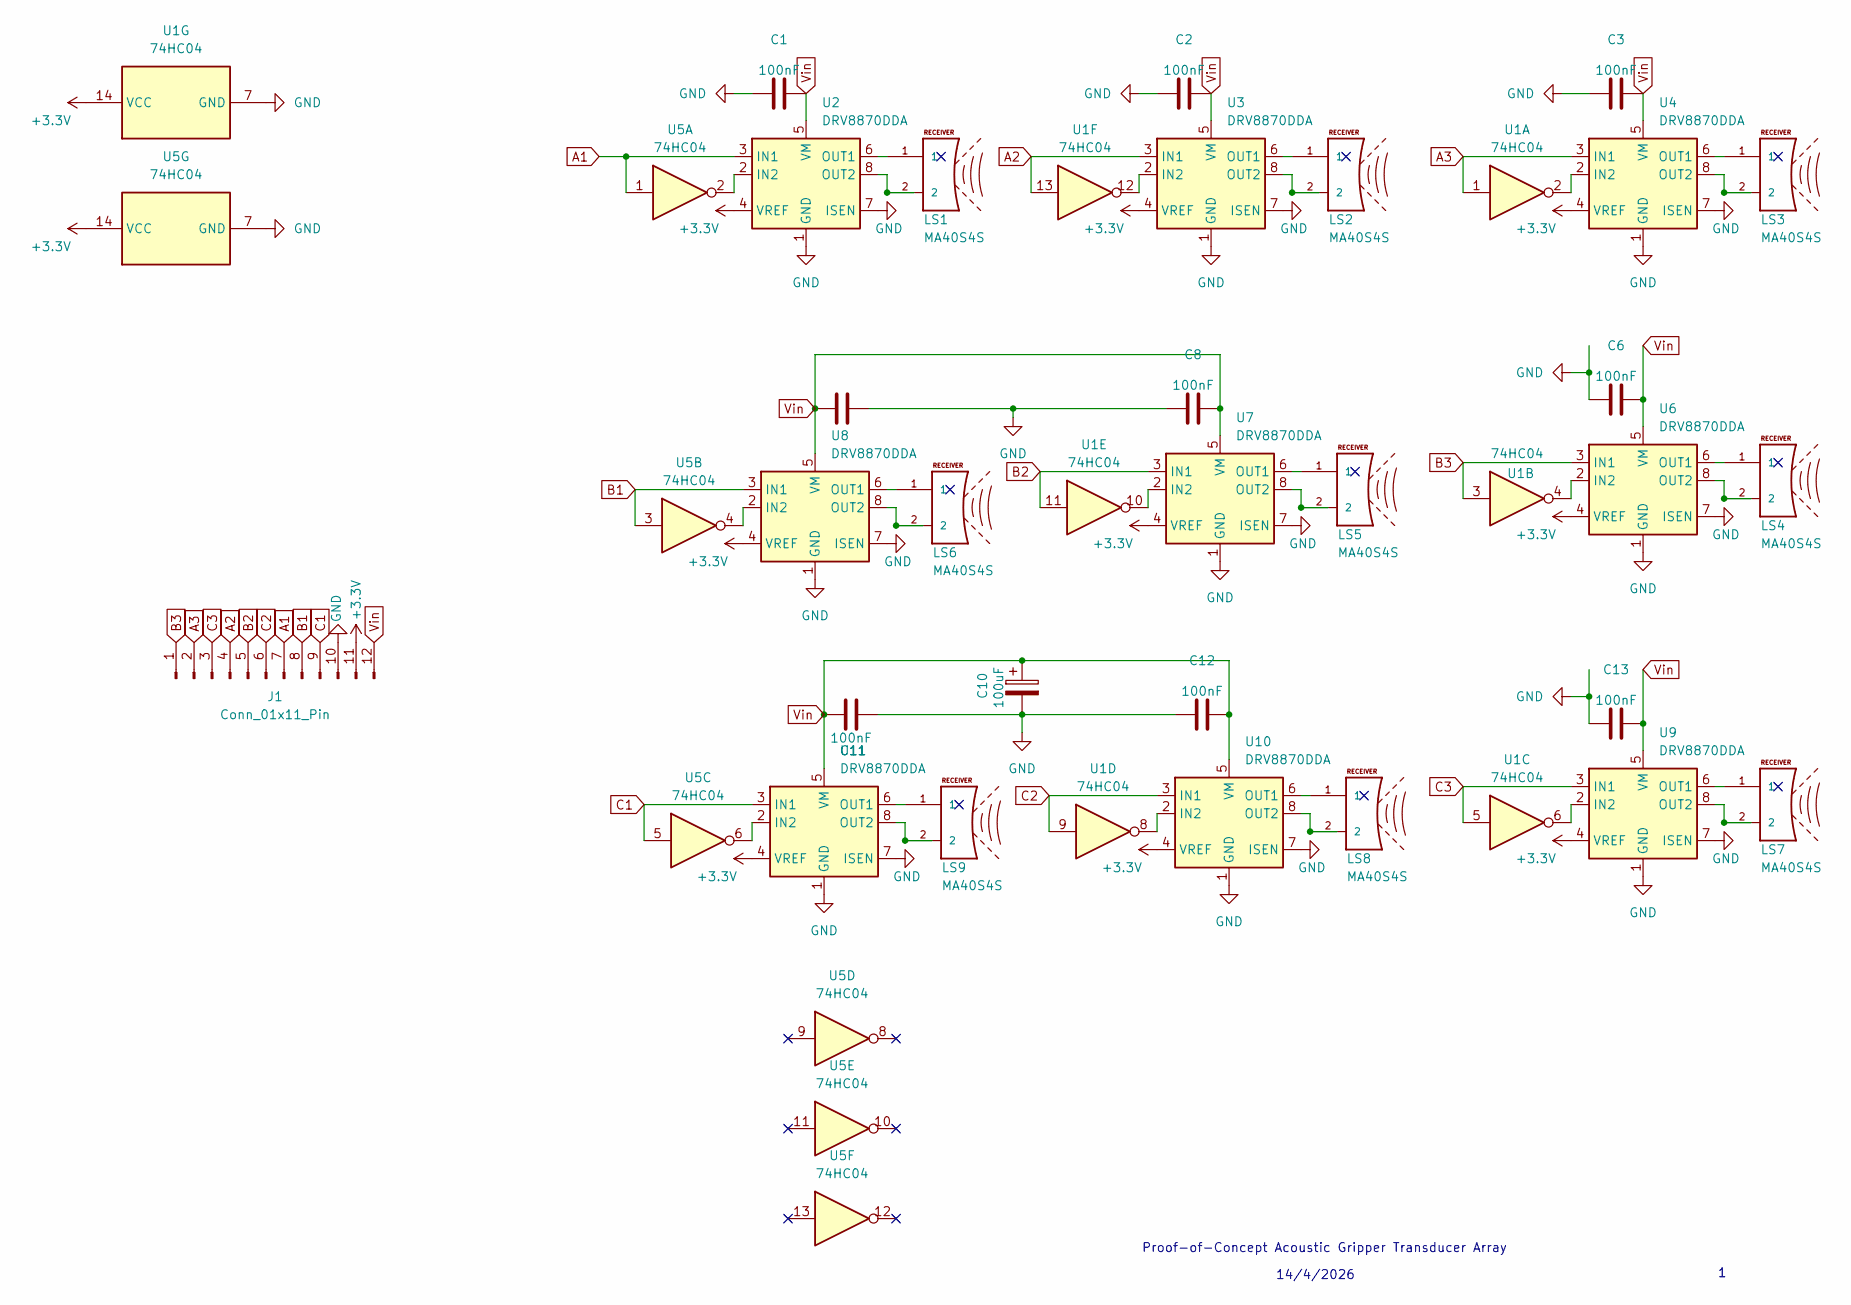
[picture p50: schematic AcousticGripper.kicad_sch]

Parts:
C1, C2, C3, C6, C7, C8, C11, C12, C13: 100nF; C_0603_1608Metric_Pad1.08x0.95mm_HandSolder
C10: 100uF; CP_Radial_D8.0mm_P3.50mm
J1: Conn_01x11_Pin; PinHeader_1x12_P2.54mm_Vertical
LS1, LS2, LS3, LS4, LS5, LS6, LS7, LS8, LS9: MA40S4S; XDCR_MA40S4S
U1, U5: 74HC04; SOIC-14_3.9x8.7mm_P1.27mm
U2, U3, U4, U6, U7, U8, U9, U10, U11: DRV8870DDA; VREG_LM5017MR_NOPB

Connections:
+3.3V: J1.11, U1.14 (VCC), U2.4 (VREF), U3.4 (VREF), U4.4 (VREF), U5.14 (VCC), U6.4 (VREF), U7.4 (VREF), U8.4 (VREF), U9.4 (VREF), U10.4 (VREF), U11.4 (VREF)
A1: J1.7, U2.3 (IN1), U5.1
A2: J1.4, U1.13, U3.3 (IN1)
A3: J1.2, U1.1, U4.3 (IN1)
B1: J1.8, U5.3, U8.3 (IN1)
B2: J1.5, U1.11, U7.3 (IN1)
B3: J1.1, U1.3, U6.3 (IN1)
C1: J1.9, U5.5, U11.3 (IN1)
C2: J1.6, U1.9, U10.3 (IN1)
C3: J1.3, U1.5, U9.3 (IN1)
GND: C1.1, C2.1, C3.1, C6.1, C7.2, C8.1, C10.2, C11.1, C12.1, C13.1, J1.10, U1.7 (GND), U2.1 (GND), U2.7 (ISEN), U2.9 (GND), U3.1 (GND), U3.7 (ISEN), U3.9 (GND), U4.1 (GND), U4.7 (ISEN), U4.9 (GND), U5.7 (GND), U6.1 (GND), U6.7 (ISEN), U6.9 (GND), U7.1 (GND), U7.7 (ISEN), U7.9 (GND), U8.1 (GND), U8.7 (ISEN), U8.9 (GND), U9.1 (GND), U9.7 (ISEN), U9.9 (GND), U10.1 (GND), U10.7 (ISEN), U10.9 (GND), U11.1 (GND), U11.7 (ISEN), U11.9 (GND)
unnamed: U2.2 (IN2), U5.2
unnamed: LS1.1, U2.6 (OUT1)
unnamed: LS1.2, U2.8 (OUT2)
unnamed: U1.12, U3.2 (IN2)
unnamed: LS2.1, U3.6 (OUT1)
unnamed: LS2.2, U3.8 (OUT2)
unnamed: U1.2, U4.2 (IN2)
unnamed: LS3.1, U4.6 (OUT1)
unnamed: LS3.2, U4.8 (OUT2)
unnamed: U1.4, U6.2 (IN2)
unnamed: LS4.1, U6.6 (OUT1)
unnamed: LS4.2, U6.8 (OUT2)
unnamed: U1.10, U7.2 (IN2)
unnamed: LS5.1, U7.6 (OUT1)
unnamed: LS5.2, U7.8 (OUT2)
unnamed: U5.4, U8.2 (IN2)
unnamed: LS6.1, U8.6 (OUT1)
unnamed: LS6.2, U8.8 (OUT2)
unnamed: U1.6, U9.2 (IN2)
unnamed: LS7.1, U9.6 (OUT1)
unnamed: LS7.2, U9.8 (OUT2)
unnamed: U1.8, U10.2 (IN2)
unnamed: LS8.1, U10.6 (OUT1)
unnamed: LS8.2, U10.8 (OUT2)
unnamed: U5.6, U11.2 (IN2)
unnamed: LS9.1, U11.6 (OUT1)
unnamed: LS9.2, U11.8 (OUT2)
Vin: C1.2, C2.2, C3.2, C6.2, C7.1, C8.2, C10.1, C11.2, C12.2, C13.2, J1.12, U2.5 (VM), U3.5 (VM), U4.5 (VM), U6.5 (VM), U7.5 (VM), U8.5 (VM), U9.5 (VM), U10.5 (VM), U11.5 (VM)

Notes on the sheet:
Proof-of-Concept Acoustic Gripper Transducer Array
14/4/2026

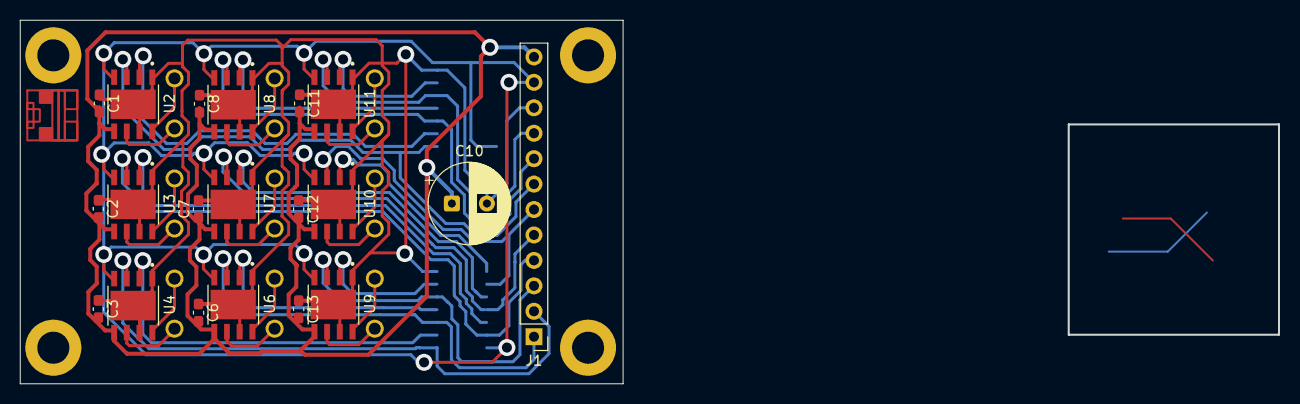
[picture p51: board AcousticGripper.kicad_pcb from above]

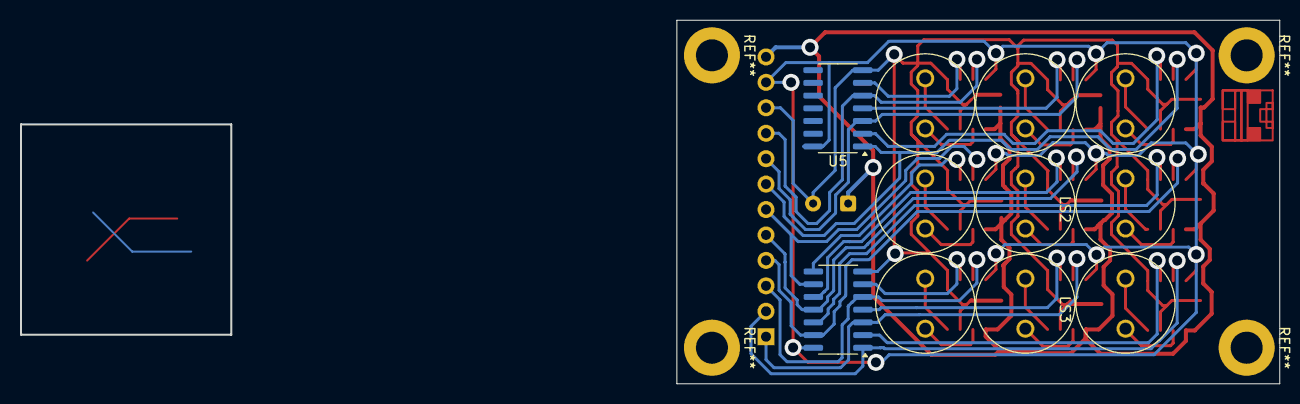
[picture p52: board AcousticGripper.kicad_pcb from below]

Board: 2 copper layers, 60.2 x 36.3 mm, 31 parts (11 on the bottom side), 39 nets.
