guomingloo/planar-acoustic-gripper/Software/FPGA/AcousticGripper_FPGA/IP_Block/synthesis/IP_Block.v

// IP_Block.v

// Generated using ACDS version 25.1 1129

`timescale 1 ps / 1 ps
module IP_Block (
		input  wire [10:0] probe  // probes.probe
	);

	altsource_probe_top #(
		.sld_auto_instance_index ("YES"),
		.sld_instance_index      (0),
		.instance_id             ("NONE"),
		.probe_width             (11),
		.source_width            (0),
		.enable_metastability    ("NO")
	) in_system_sources_probes_0 (
		.probe (probe)  // probes.probe
	);

endmodule
